nikitchm/naumannlab_2p1/projects/NL_2p1/NL_2p1 overview.html

2

projects

common parts & manuals

coding

Teensy_Arduino

electronics

stepper motor drivers

Sparkfun Easydriver

Sparkfun Easydriver

Uctronics-power-source_mount

v1

laser_module_power_control_mount

STL

laser_module_power_control_mount v2

F3D

laser_module_power_control_mount_eng0.1_inf40_sup_adh_UMS3

GCODE

laser_module_power_control_mount_v1

PNG

UMS3_laser_module_power_control_mount

3MF

v2

laser_module_power_control_mount v6

F3D

laser_module_power_control_mount_v2

STL

laser_module_power_control_mount_v2

PNG

laser_module_power_control_mount_v2_back

JPG

laser_module_power_control_mount_v2_eng0.1_inf40_sup_no-adh_UMS3

GCODE

laser_module_power_control_mount_v2_front

JPG

UMS3_laser_module_power_control_mount_v2

3MF

v2.1

laser_module_power_control_mount v7

F3D

laser_module_power_control_mount_v2

PNG

laser_module_power_control_mount_v2_back

JPG

laser_module_power_control_mount_v2_front

JPG

laser_module_power_control_mount_v2.1

STL

laser_module_power_control_mount_v2.1_eng0.1_inf40_no-sup_no-adh_UMS3

GCODE

laser_module_power_control_mount_v2.1_UMS3

3MF

Uctronics power source with relay mount

USB

FLIR Cameras

files

asset_pdf_25493243

PDF

cmosis_CMV4000-10-2015-773293

PDF

GS3-U3-Technical-Reference

PDF

FLIR Cameras

LED

Thorlabs

M780L3-SpecSheet

PDF

Thorlabs M780L3

manufacturing

3D printing

3D printing

Duke University Co-Lab specific printing

Olympus objective

files

N20X-PFH-Objective

STEP

Olympus XLUMPLFLN20XW

Common parts

NL_2p1

extra modules

behavioral imaging

files

tissue camera past objective simulation

JSON

tissue-camera_ray-optics-simulation_sketch1

PNG

Behavioral imaging

Tissue camera

cooling system

Cooling system

enclosure

Enclosure

LED lighting

software modules

Software modules

stage

files

NL-2p1_z-stage actuator

PNG

Stage

Extra modules

Projector system

Spectra-Physics Insight-X3

Stepper motors

files

2p-scanning

XLSX

3D Model

NL-2p1_3D-model

PNG

NL-2p1_asmbly.xlsx

main scanning path

pre-scanner

pics

NL-2p1_beam-forming module

PNG

NL-2p1_periscope

PNG

NL-2p1_pre-scanner

PNG

Beam forming

construction, alignment

maintenance alignment

Periscope

Pre-scanner

scanner

pics

NL-2p1_parabolic-galvo-scanner

PNG

Parabolic galvo scanner

Scan-Tube lens system

Main scanning path

Objective

Piezo motor

Shutter

parts and purchasing system

Purchasing system

path 2 - Photostimulation module

path 2 - Photostimulation module

Photostim Galvo Scanner

Pre-SLM

Scan-Tube Lens system & Polarization beamsplitter

SLM

SLM-to-galvo

PMT detection system

files

alignment

20210906_195607

JPG

20210906_202945

JPG

20210906_203235

JPG

20210907_190710

JPG

20210907_190715

JPG

20210907_193334

JPG

20210907_193513

JPG

20210907_193956

JPG

20210908_090937

JPG

spectra

FF01-554_23_Spectrum

TXT

FF01-590_36_Spectrum

TXT

NL-2p1_filters-dichroics_spectra

PNG

tmp

red_fluorophores_filters_sources2b

PNG

NL-2p1_green-channel

PNG

NL-2p1_green-channel_optics

PNG

NL-2p1_PMT detection system

PNG

NL-2p1_PMT detection system_hightlighted optics

PNG

NL-2p1_red-channels

PNG

NL-2p1_red-channels_optics

PNG

maintenance alignment

PMT detection system

PMT detection system spectra

Software assemblies and usage

Software assemblies and usage

Design of the modular two-photon microscope with photostimulation implemented in Naumann Lab

NL_2p1 content

NL_2p1 overview

TODO

# NL_2p1 overview

The NL-2p1 is a custom built two-photon laser microscope designed and constructed for the Eva Naumann's lab at Duke University. It features 2 scanning paths (which can be used for imaging and photostimulation) with an SLM in one of the paths, 4 PMT detection channels, behavioral and tissue cameras, 2D stage for positioning the sample under the microscope (for vertical positioning, the detection module is moved), and several experimental setups for zebrafish studies.

The 3D model of the microscope can be viewed and downloaded here. Note that the online version of the model is opened in a browser and doesn't require an access to Fusion 360 software. However, the experience of viewing the model online differs quite significantly from opening the model directly in Fusion 360, and we recommend the latter if possible.

See NL_2p1 content for links to the different parts / modules of the microscope, alignment, software, etc..

Table Of Contents

NL_2p1 overview
