nikitchm/naumannlab_2p1/projects/NL_2p1/files/2p-scanning.xlsx

Sheet: rigs
cat2 | cat1 | cat0 | assembly | subtotal | part name | Qty | Price ea, $ | url | vendor | catalog # | pic | lead time | extra info | Notes
 | General Settings :
 |  | Root pictures' folder : |  |  | File:////C:\Users\nikit\Dropbox_max\rnd\microframe\pics\
 |  | Template for the file hyperlink: |  |  | HYPERLINK(rigs!$E$3&"", "") |  |  |  |  |  |  |  |  | To turn it into a valid hyperlink, fill the space in between the quotation marks and add "=".
 |  | Example of referring to a file: |  |  | N20X-PFH.jpg
 | TODO |  |  |  | ?add a type column (optics, opto-mech, etc)?; ?Cat (Category) / Class / Descriptor? ; "units column"
 |  |  | duke-2p-scanner < |  |  |  | 0.00
 |  |  |  |  | Pre-rig
 |  |  |  |  | Upper kinematic
 |  |  |  |  | Scanner
 |  |  |  |  | Detection
 |  |  |  |  | Stage
 |  |  |  |  | Behavior
 |  |  |  |  | Stimulation
 |  |  | > |  | slm-ChR2 stim
 |  |  | 2p-microscope 1 < |  |  |  | #REF!
 |  | pre-rig |  |  | pre-rig assembly 1 < | 1 | 2008.48
 |  | Vertical Kinematics |  |  | vertical kinematics 1 < | 1 | 1208.30 |  |  |  |  |  |  | todo: ER rodes might be wrong
 |  | Scanner |  |  | scanner 1 < | 1 | 8664.13
 |  | Detection-primary |  |  | 0 | 1 | 0.00 |  |  |  |  |  |  | TODO: optimize lenses, filter and the dichroic
 |  | Detection-secondary |  |  | Single 2ry channel asmbly < | 1 | 5420.22 |  |  |  |  |  |  | TODO: optimize lenses, filter and the dichroic
 |  | Detection-shutter |  |  | objective shutter, Uniblitz VS25-based, v1 < | 1 | 985.00
 |  | Stage |  |  | DIY, acrylic < | 1 | 1552.16 |  |  |  |  |  |  | IR illumination is likely incorrect
 |  | stage-motion |  |  | 3 1-axis DIY, micrometer based stages < | 1 | 2494.54
 |  | Beh im |  |  | Grasshopper3NIR, singlet lens focusing 1 < | 1 | 2091.64 |  |  |  |  |  |  | todo: filtes, IR illumination,
 |  | experiments |  |  |  | 1
 |  | slm-ChR2 stim |  |  |  | 1
 |  | extra stuff, not in design |  |  | Extra stuff < | 1 | 0.00 |  |  |  |  |  |  | the total price will depend on what is decided to include in the order…
 |  |  |  |  | #REF! | 1 | #REF!
 |  |  |  |  | #REF! | 1 | #REF!
 |  |  |  |  | Plössl-type 50mm scan lens < | 1 | 235.52
 |  |  |  |  | 50mm FL, Ø30 Achromat Doublet, w/o XY adjustment < | 1 | 140.15
 |  |  | > |  | AC508-300-B - f=300.0 mm, Ø2" Achromatic Doublet, ARC: 650-1050 nm | 1 | 134.64
 |  |  | consider swapping all the protected silver mirrors with Ultrafast-enhanced silver mirrors: |  |  |  |  |  |  |  |  |  |  | UM10-AG - Ø1" Ultrafast-Enhanced Silver Mirror, 750 - 1000 nm
 |  |  | they offer lower (specified) dispertion and 3% higher reflectance
 |  |  | extra2 <
 |  |  |  |  | extra2 < | 1 | 0
 |  |  | > |  | extra3 < | 1 | 0
 |  |  | extra3 <
 |  |  | > |  | extra4 < | 1 | 0.00
 |  |  | 2p-microscope 2 < | 44784.99
pre-rig < |  |  |  | 4880.49
 |  |  |  |  | laser telescope 2 < | 1 | 530.68 |  |  |  | telescope_asmbly1.png
 |  |  |  |  | precision pinhole < | 1 | 269.32 |  |  |  | mounted_precision-pinhole_50um_xy-mount.png
 |  |  |  |  | power meter with display 1-asmbly for attenuator < | 1 | 1883.47 |  |  |  | power meter-attenuator asmbly.png
 |  |  |  |  | half-waveplate + Glan-polarizer diy 1 < | 1 | 1894.95 |  |  |  | power-controller-4_v4-b.png
> |  |  |  |  | rig shutter, 5W beam block, diy3 < | 1 | 302.07 |  |  |  | 0
Vertical Kinematics < |  |  |  | 949.14
 |  |  |  |  | 12"x18" vertical board < | 1 | 313.46 |  |  |  | 12inx18in vertical board.png
> |  |  |  |  | periscope 2 arms -1 < | 1 | 635.68 |  |  |  | periscope_2arms-1_v5.png
Scanner, x-y-z <
 |  | parabolic-mirror galvo conjugation asmbly < |  | 6238.13
 |  |  |  |  | galvo-parbolic-conjugate-system, unmounted < | 1 | 5922.27
 |  | > |  |  | galvo-parbolic-conjugate-system mount < | 1 | 315.86
 |  | ETL z-scanner <> |  |  | ETL mounted z-scanner 1 < | 1 | 2236.49
 |  | scan-tube lens assembly < |  | 1322.62
 |  |  |  |  | Plössl-type 40mm scan lens < | 1 | 283.30
 |  |  |  |  | Mounted 250mm tube lens, AC508-250-B + CXY2 < | 1 | 333.09
> |  | > |  |  | Scanner telescope 2" 180degree steering and suport -2 | 1 | 706.23
Detection < |  |  |  | 20639.78
 |  | Tissue Camera <> |  |  | Grasshopper3NIR (1" sensor) assembly < | 1 | 1344.24
 |  | primary detection arm < |  |  | main channel, Hamamatsu-R3896_side-on-PMT, v1 < | 1 | 5017.24
 |  | secondary detection arm < |  |  | Single 2ry channel asmbly < | 1 | 5420.22
 |  | objective asmbly <> |  |  | Olympus XLUMPLFLN20XW objective, SM1 interface < | 1 | 6916.86
 |  | z-stage mounts <> |  |  | vertical stage servo and mounts, v1 < | 1 | 1021.22
 |  | detection channels filters and dichroics < |  |  | mCherry dichroic/filter set, v1< | 1 | 920.00
> |  | > |  |  | reminder: choose dichroic/filter set for the 1st 2ry channel | -1
DAQ card for the imaging part of the microscope < |  |  |  |  | NI PCIe-6374, 4 AI (16-Bit, 3.5 MS/s/ch), 2 AO (16 bit, 3.3 MS/s), 24 DIO | 1 | 2380 | https://www.ni.com/en-us/support/model.pcie-6374.html | National Instruments | PCIe-6374
> |  |  | > |  | reminder: DAQ card: 1 input channel | -3
Stage <> |  |  |  |  | DIY, acrylic < | 1 | 1552.16
stage-motion <> |  |  |  |  | 3 1-axis DIY, micrometer based stages < | 1 | 2494.54
Beh im <> |  |  |  |  | Grasshopper3NIR, singlet lens focusing 1 < | 1 | 2091.64

Sheet: parts-vendors
Vendors | cat1 | cat0 | assembly | Part name | Qty | Price ea, $ | url | vendor | catalog # | pic | lead time, weeks | extra info | manufacturer | Notes
Thorlabs <
 | Mechanical <
 |  | Construction rail system <
 |  |  |  | XT95-1500 - 95 mm Construction Rail, Clear Anodized, L = 1500 mm | 1 | 306.00 | https://www.thorlabs.com/thorproduct.cfm?partnumber=XT95-1500 | thorlabs | XT95-1500 | XT95-1500.jpg |  |  |  | Main vertical column. ?Cut down to 4'?
 |  |  |  | XT95P3 - Base Plate for 95 mm Rails | 1 | 51.51 | https://www.thorlabs.com/thorproduct.cfm?partnumber=XT95P3 | thorlabs | XT95P3 | XT95P3.jpg |  |  |  | For vertical mounting of 95 mm Rails
 |  |  |  | XT95P11 - Drop-On Rail Carriage for 95 mm Rails, 1/4"-20 Tapped Holes | 1 | 83.39 | https://www.thorlabs.com/thorproduct.cfm?partnumber=XT95P11 | thorlabs | XT95P11
 |  |  |  | XT95P12 - Rail Plate for 95 mm Rails, 1/4"-20 Tapped Holes | 1 | 46.16 | https://www.thorlabs.com/thorproduct.cfm?partnumber=XT95P12 | thorlabs | XT95P12 | XT95P12.jpg
 |  |  |  | XT66-500 - 66 mm Construction Rail, L = 500 mm | 1 | 85.43 | https://www.thorlabs.com/thorproduct.cfm?partnumber=XT66-500 | thorlabs | XT66-500 | XT66-500.jpg |  |  |  | Upper side-arm holding two translation mirrors
 |  | > |  | XT66C4 - Clamping Platform for 66 mm Rails, 1/4" Counterbored Slot, 40 mm Long | 2 | 28.56 | https://www.thorlabs.com/thorproduct.cfm?partnumber=XT66C4 | thorlabs | XT66C4 | XT66C4.jpg
 |  | Ø1/2" Post mounting bases <
 |  |  |  | BA1 - Mounting Base, 1" x 3" x 3/8" | 1 | 5.60 | https://www.thorlabs.com/thorproduct.cfm?partnumber=BA1 | thorlabs | BA1 | BA1.jpg
 |  |  |  | BA2 - Mounting Base, 2" x 3" x 3/8" | 1 | 7.30 | https://www.thorlabs.com/thorproduct.cfm?partnumber=BA2 | thorlabs | BA2 | BA2.jpg
 |  |  |  | BA1S - Mounting Base, 1" x 2.3" x 3/8" | 1 | 5.20 | https://www.thorlabs.com/thorproduct.cfm?partnumber=BA1S | thorlabs | BA1S | BA1S.jpg
 |  |  |  | BE1 - Ø1.25" Studded Pedestal Base Adapter, 1/4"-20 Thread | 1 | 9.49 | https://www.thorlabs.com/thorproduct.cfm?partnumber#BE1-P5 | thorlabs | BE1
 |  |  |  | BE1R - Ø1.25" Magnetic Studded Pedestal Base Adapter, 1/4"-20 Thread | 1 | 16.73 | https://www.thorlabs.com/thorproduct.cfm?partnumber#BE1R#ad-image-0 | thorlabs | BE1R
 |  |  |  | BE1T - Tapped Mechanical Component Base, 1/4"-20 Thread | 1 | 10.06 | https://www.thorlabs.com/thorproduct.cfm?partnumber=BE1T | thorlabs | BE1T
 |  |  |  | BE2T - Tapped Mechanical Component Base, 8-32 Thread | 1 | 10.06 | https://www.thorlabs.com/thorproduct.cfm?partnumber=BE2T | thorlabs | BE2T
 |  |  |  | RS8M - Ø25 mm Post Spacer, Thickness = 8 mm | 1 | 8.77 | https://www.thorlabs.com/thorproduct.cfm?partnumber=RS8M | thorlabs | RS8M
 |  |  |  | CF038-P5 - Clamping Fork, 0.38" Counterbored Slot, Universal, 5 Pack | 5 | 41.40 | https://www.thorlabs.com/thorproduct.cfm?partnumber=CF038-P5 | thorlabs | CF038-P5
 |  |  |  | CF125 - Clamping Fork, 1.24" Counterbored Slot, Universal | 1 | 8.95 | https://www.thorlabs.com/thorproduct.cfm?partnumber#CF125#ad-image-0 | thorlabs | CF125
 |  |  |  | CF125C - Clamping Fork, 1.24" Counterbored Slot, 1/4"-20 Captive Screw | 1 | 11.69 | https://www.thorlabs.com/thorproduct.cfm?partnumber=CF125C#ad-image-0 | thorlabs | CF125C
 |  | > |  | CF175 - Clamping Fork, 1.76" Counterbored Slot, Universal | 1 | 10.30 | https://www.thorlabs.com/thorproduct.cfm?partnumber#CF175-P5 | thorlabs | CF175
 |  | stages <
 |  |  |  | DT12 - 1/2" Dovetail Translation Stage, 8-32 Taps | 1 | 84.14 | https://www.thorlabs.com/thorproduct.cfm?partnumber=DT12 | thorlabs | DT12
 |  | >
 |  | Ø1/2" Post holders < |  |  |  |  | https://www.thorlabs.com/newgrouppage9.cfm?objectgroup_id=1268 | thorlabs
 |  |  |  | PH1 - Ø1/2" Post Holder, Spring-Loaded Hex-Locking Thumbscrew, L = 1" | 1 | 7.03 | https://www.thorlabs.com/thorproduct.cfm?partnumber=PH1 | thorlabs | PH1 | PH1.jpg
 |  |  |  | PH1.5 - Ø1/2" Post Holder, Spring-Loaded Hex-Locking Thumbscrew, L = 1.5" | 1 | 7.22 | https://www.thorlabs.com/thorproduct.cfm?partnumber=PH1.5 | thorlabs | PH1.5 | PH1.5.jpg
 |  |  |  | PH2 - Ø1/2" Post Holder, Spring-Loaded Hex-Locking Thumbscrew, L = 2" | 1 | 7.70 | https://www.thorlabs.com/thorproduct.cfm?partnumber=PH2 | thorlabs | PH2 | PH2.jpg
 |  |  |  | PH3 - Ø1/2" Post Holder, Spring-Loaded Hex-Locking Thumbscrew, L = 3" | 1 | 8.27 | https://www.thorlabs.com/thorproduct.cfm?partnumber=PH3=ad-image-0 | thorlabs | PH3 | PH3.jpg
 |  | > |  | PH4 - Ø1/2" Post Holder, Spring-Loaded Hex-Locking Thumbscrew, L = 4" | 1 | 9.45 | https://www.thorlabs.com/thorproduct.cfm?partnumber=PH4#ad-image-0 | thorlabs | PH4
 |  | Ø1/2" Posts < |  |  |  |  | https://www.thorlabs.com/newgrouppage9.cfm?objectgroup_id=1266 | thorlabs
 |  |  |  | TR075 - Ø1/2" Optical Post, SS, 8-32 Setscrew, 1/4"-20 Tap, L = 0.75" | 1 | 4.74 | https://www.thorlabs.com/thorproduct.cfm?partnumber=TR075 | thorlabs | TR075 | TR075.jpg |  |  |  | SS-stainless steel
 |  |  |  | TR1 - Ø1/2" Optical Post, SS, 8-32 Setscrew, 1/4"-20 Tap, L = 1" | 1 | 4.74 | https://www.thorlabs.com/thorproduct.cfm?partnumber=TR1 | thorlabs | TR1 | TR1.jpg
 |  |  |  | TR1.5 - Ø1/2" Optical Post, SS, 8-32 Setscrew, 1/4"-20 Tap, L = 1.5" | 1 | 4.97 | https://www.thorlabs.com/thorproduct.cfm?partnumber=TR1.5 | thorlabs | TR1.5 | TR1.5.jpg
 |  |  |  | TR2 - Ø1/2" Optical Post, SS, 8-32 Setscrew, 1/4"-20 Tap, L = 2" | 1 | 5.19 | https://www.thorlabs.com/thorproduct.cfm?partnumber=TR2 | thorlabs | TR2 | TR2.jpg
 |  |  |  | TR3 - Ø1/2" Optical Post, SS, 8-32 Setscrew, 1/4"-20 Tap, L = 3" | 1 | 5.42 | https://www.thorlabs.com/thorproduct.cfm?partnumber=TR3 | thorlabs | TR3 | TR3.jpg
 |  |  |  | TR4 - Ø1/2" Optical Post, SS, 8-32 Setscrew, 1/4"-20 Tap, L = 4" | 1 | 5.87 | https://www.thorlabs.com/thorproduct.cfm?partnumber=TR4 | thorlabs | TR4 | TR4.jpg
 |  |  |  | TR6 - Ø1/2" Optical Post, SS, 8-32 Setscrew, 1/4"-20 Tap, L = 6" | 1 | 6.91 | https://www.thorlabs.com/thorproduct.cfm?partnumber=TR6 | thorlabs | TR6 | TR6.jpg
 |  | > |  | TR8 - Ø1/2" Optical Post, SS, 8-32 Setscrew, 1/4"-20 Tap, L = 8" | 1 | 8.28 | https://www.thorlabs.com/thorproduct.cfm?partnumber=TR8 | thorlabs | TR8 | TR8.jpg
 |  | Ø1/2" Post clamps <
 |  |  |  | RA180 - Right-Angle End Clamp for Ø1/2" Posts, 1/4"-20 Stud and 3/16" Hex | 1 | 10.81 | https://www.thorlabs.com/thorproduct.cfm?partnumber=RA180 | thorlabs | RA180 | RA180.jpg
 |  |  |  | RA90 - Right-Angle Clamp for Ø1/2" Posts, 3/16" Hex | 1 | 9.76 | https://www.thorlabs.com/thorproduct.cfm?partnumber=RA90 | thorlabs | RA90 | RA90.jpg
 |  | > |  | SWC - Rotating Clamp for Ø1/2" Posts, 360° Continuously Adjustable, 3/16" Hex | 1 | 23.56 | https://www.thorlabs.com/thorproduct.cfm?partnumber=SWC | thorlabs | SWC | SWC.jpg
 |  | Ø1.5" <
 |  |  |  | C1515 - Ø1.5" Mounting Post Bracket, 1/4"-20 Taps | 4 | 100.98 | https://www.thorlabs.com/thorproduct.cfm?partnumber=C1515 | thorlabs | C1515 | C1515.jpg |  |  |  | ours didn’t have a clamp…
 |  | > |  | P8 - Ø1.5" Mounting Post, 1/4"-20 Taps, L = 8" | 4 | 56.36 | https://www.thorlabs.com/thorproduct.cfm?partnumber=P8 | thorlabs | P8 | P8.jpg
 |  | Arm clamps <
 |  |  |  | VC1 - Small V-Clamp with PM3 Clamping Arm, 0.75" Long | 1 | 40.55 | https://www.thorlabs.com/thorproduct.cfm?partnumber=VC1 | thorlabs | VC1 | VC1.jpg |  |  |  | Comes with PM4 arm, which isn't large enough for the liquid lens and has to be replaced with the PM4 arm
 |  |  |  | PM4 - Large Adjustable Clamping Arm, 6-32 Threaded Post | 1 | 22.95 | https://www.thorlabs.com/thorproduct.cfm?partnumber=PM4 | thorlabs | PM4 | PM4.jpg
 |  | > |  | PM3 - Small Adjustable Clamping Arm, 6-32 Threaded Post | 1 | 18.77 | https://www.thorlabs.com/thorproduct.cfm?partnumber=PM3 | thorlabs | PM3 | PM3.jpg |  |  |  | In the rig -- discontinued PM2
 |  | 30mm cage system <
 |  |  |  | C6W - 30 mm Cage Cube, Ø6 mm Through Holes | 1 | 63.75 | https://www.thorlabs.com/thorproduct.cfm?partnumber=C6W | thorlabs | C6W | C6W.jpg
 |  |  |  | C4W - 30 mm Cage Cube | 1 | 60.44 | https://www.thorlabs.com/thorproduct.cfm?partnumber=C4W | thorlabs | C4W | C4W.jpg
 |  |  |  | C4W-CC - 30 mm Cage Cube Connector for C4W and C6W Series Cubes | 1 | 54.65 | https://www.thorlabs.com/thorproduct.cfm?partnumber#C4W-CC | thorlabs | C4W-CC
 |  |  |  | B4C - Kinematic Cage Cube Platform for C4W/C6W | 1 | 98.43 | https://www.thorlabs.com/thorproduct.cfm?partnumber=B4C | thorlabs | B4C | B4C.jpg
 |  |  |  | FFM1 - 30-mm-Cage-Compatible Rectangular Filter Mount | 1 | 58.40 | https://www.thorlabs.com/thorproduct.cfm?partnumber=FFM1 | thorlabs | FFM1 | FFM1.jpg
 |  |  |  | SM1CP2 - Externally SM1-Threaded End Cap | 1 | 17.75 | https://www.thorlabs.com/thorproduct.cfm?partnumber=SM1CP2 | thorlabs | SM1CP2 | SM1CP2.jpg
 |  |  |  | B1C - Blank Cover Plate | 1 | 18.77 | https://www.thorlabs.com/thorproduct.cfm?partnumber=B1C | thorlabs | B1C | B1C.jpg
 |  |  |  | ER6 - Cage Assembly Rod, 6" Long, Ø6 mm | 1 | 8.65 | https://www.thorlabs.com/thorproduct.cfm?partnumber=ER6 | thorlabs | ER6 | ER6.jpg
 |  |  |  | ER8 - Cage Assembly Rod, 8" Long, Ø6 mm | 1 | 11.70 | https://www.thorlabs.com/thorproduct.cfm?partnumber=ER8 | thorlabs | ER8 | ER8.jpg
 |  |  |  | CP02B - 30 mm Cage Mounting Bracket | 1 | 14.08 | https://www.thorlabs.com/thorproduct.cfm?partnumber=CP02B | thorlabs | CP02B | CP02B.jpg
 |  |  |  | SM1T2 - SM1 (1.035"-40) Coupler, External Threads, 0.5" Long | 1 | 20.30 | https://www.thorlabs.com/thorproduct.cfm?partnumber=SM1T2 | thorlabs | SM1T2 | SM1T2.jpg
 |  |  |  | SM1L03 - SM1 Lens Tube, 0.30" Thread Depth, One Retaining Ring Included | 1 | 12.16 | https://www.thorlabs.com/thorproduct.cfm?partnumber=SM1L03 | thorlabs | SM1L03 | SM1L03.jpg
 |  |  |  | SM1L05 - SM1 Lens Tube, 0.50" Thread Depth, One Retaining Ring Included | 1 | 12.59 | https://www.thorlabs.com/thorproduct.cfm?partnumber=SM1L05 | thorlabs | SM1L05 | SM1L05.jpg
 |  |  |  | SM1L10 - SM1 Lens Tube, 1.00" Thread Depth, One Retaining Ring Included | 1 | 14.25 | https://www.thorlabs.com/thorproduct.cfm?partnumber=SM1L10 | thorlabs | SM1L10 | SM1L10.jpg
 |  |  |  | SM30L05 - SM30 Lens Tube, 1/2" Thread Depth, One Retaining Ring Included | 1 | 28.05 | https://www.thorlabs.com/thorproduct.cfm?partnumber#SM30L05 | thorlabs | SM30L05
 |  |  |  | SM30L10 - SM30 Lens Tube, 1" Thread Depth, One Retaining Ring Included | 1 | 30.09 | https://www.thorlabs.com/thorproduct.cfm?partnumber=SM30L10 | thorlabs | SM30L10
 |  |  |  | SM1RR - SM1 Retaining Ring for Ø1" Lens Tubes and Mounts | 1 | 4.50 | https://www.thorlabs.com/thorproduct.cfm?partnumber=SM1RR | thorlabs | SM1RR | SM1RR.jpg
 |  |  |  | SM1A9 - Adapter with External C-Mount Threads and Internal SM1 Threads | 1 | 18.82 | https://www.thorlabs.com/thorproduct.cfm?partnumber=SM1A9 | thorlabs | SM1A9 | SM1A9.jpg
 |  |  |  | CP35 - 30 mm Cage Plate with Ø1" Double Bore, 8-32 Tap | 1 | 18.68 | https://www.thorlabs.com/thorproduct.cfm?partnumber=CP35 | thorlabs | CP35 | CP35.jpg |  |  |  | The replacement for the now obsolete CP06
 |  |  |  | CP20S - 30 mm Cage System Iris, Ø20.0 mm Maximum Aperture | 1 | 88.00 | https://www.thorlabs.com/thorproduct.cfm?partnumber=CP20S | thorlabs | CP20S | CP20S.jpg
 |  |  |  | LCP02 - 30 mm to 60 mm Cage Plate Adapter, 8-32 Tap | 1 | 39.78 | https://www.thorlabs.com/thorproduct.cfm?partnumber=LCP02 | thorlabs | LCP02 | LCP02.jpg
 |  |  |  | SPT1 - Coarse ±1 mm XY Slip Plate Positioner, 30 mm Cage Compatible | 1 | 66.55 | https://www.thorlabs.com/thorproduct.cfm?partnumber=SPT1 | thorlabs | SPT1 | SPT1.jpg
 |  |  |  | CXY1 - 30 mm Cage System, XY Translating Lens Mount for Ø1" Optics | 1 | 187.20 | https://www.thorlabs.com/thorproduct.cfm?partnumber=CXY1=ad-image-0 | thorlabs | CXY1 | CXY1.jpg
 |  |  |  | CP360R - Pivoting, Quick-Release, Ø1" Optic Mount for 30 mm Cage System | 1 | 95.63 | https://www.thorlabs.com/thorproduct.cfm?partnumber=CP360R | thorlabs | CP360R | CP360R.jpg
 |  |  |  | CRM1 - Cage Rotation Mount for Ø1" Optics, SM1 Threaded, 8-32 Tap | 1 | 87.39 | https://www.thorlabs.com/thorproduct.cfm?partnumber=CRM1 | thorlabs | CRM1 | CRM1.jpg
 |  |  |  | CP30 - 30 mm to 30 mm Cage System Right-Angle Adapter | 1 | 51.50 | https://www.thorlabs.com/thorproduct.cfm?partnumber=CP30 | thorlabs | CP30 | CP30.jpg
 |  |  |  | CP08 - SM1-Threaded 30 mm Cage Plate with Flexure Clamping, 1 Retaining Ring, 8-32 Tap | 1 | 19.79 | https://www.thorlabs.com/thorproduct.cfm?partnumber=CP08 | thorlabs | CP08 | CP08.jpg
 |  |  |  | CP03 - Ø35 mm Aperture, 30 mm Cage Plate, 0.35" Thick, 8-32 Tap | 1 | 18.77 | https://www.thorlabs.com/thorproduct.cfm?partnumber#CP03 | thorlabs | CP03
 |  | 60mm cage system <
 |  |  |  | LCP01 - 60 mm Cage Plate, SM2 Threads, 0.5" Thick, 8-32 Tap (Two SM2RR Retaining Rings Included) | 1 | 38.76 | https://www.thorlabs.com/thorproduct.cfm?partnumber=LCP01 | thorlabs | LCP01
 |  |  |  | LCP02 - 30 mm to 60 mm Cage Plate Adapter, 8-32 Tap | 1 | 39.78 | https://www.thorlabs.com/thorproduct.cfm?partnumber=LCP02 | thorlabs | LCP02
 |  |  |  | LCP01B - 60 mm Cage Mounting Bracket | 1 | 30.35 | https://www.thorlabs.com/thorproduct.cfm?partnumber#LCP01B | thorlabs | LCP01B
 |  |  |  | LCP08 - 60 mm Cage Plate, SM2 Threads, Enhanced Clamping, 0.5" Thick, 8-32 Tap (One SM2RR Retaining Ring Included) | 1 | 49.98 | https://www.thorlabs.com/thorproduct.cfm?partnumber#LCP08 | thorlabs | LCP08
 |  |  |  | LCP09 - 60 mm Cage Plate with Ø2.2" (Ø56.0 mm) Double Bore for SM2 Lens Tube Mounting | 1 | 45.72 | https://www.thorlabs.com/thorproduct.cfm?partnumber=LCP09 | thorlabs | LCP09
 |  |  |  | CXY2 - 60 mm Cage System Translating Lens Mount for Ø2" Optics | 1 | 198.45 | https://www.thorlabs.com/thorproduct.cfm?partnumber=CXY2 | thorlabs | CXY2
 |  | adapters <
 |  |  |  | SM1A16 - Adapter with External SM1 Threads and Internal SM30 Threads | 1 | 21.93 | https://www.thorlabs.com/thorproduct.cfm?partnumber#SM1A16 | thorlabs | SM1A16
 |  |  |  | SM1A39 - Adapter with External C-Mount Threads and External SM1 Threads | 1 | 19.99 | https://www.thorlabs.com/thorproduct.cfm?partnumber=SM1A39 | thorlabs | SM1A39
 |  |  |  | SM2A27 - Adapter with External SM2 Threads and Internal M49 x 0.75 Threads | 1 | 31.12 | https://www.thorlabs.com/thorproduct.cfm?partnumber#SM2A27 | thorlabs | SM2A27
 |  |  |  | SM2A30 - Adapter with External SM2 Threads and Internal M43 x 0.5 Threads | 1 | 16.56 | https://www.thorlabs.com/thorproduct.cfm?partnumber#SM2A30 | thorlabs | SM2A30
 |  |  |  | SM1A16 - Adapter with External SM1 Threads and Internal SM30 Threads | 1 | 21.93 | https://www.thorlabs.com/thorproduct.cfm?partnumber#SM1A16 | thorlabs | SM1A16
 |  |  |  | SM1A9 - Adapter with External C-Mount Threads and Internal SM1 Threads | 1 | 18.82 | https://www.thorlabs.com/thorproduct.cfm?partnumber#SM1A9 | thorlabs | SM1A9
 |  |  |  | SM1A12 - Adapter with External SM1 Threads and Internal M25 x 0.75 Threads | 1 | 21.86 | https://www.thorlabs.com/thorproduct.cfm?partnumber=SM1A12 | thorlabs | SM1A12
 |  | >
 |  | ER rods <
 |  |  |  | ER025 - Cage Assembly Rod, 1/4" Long, Ø6 mm | 1 | 5.05 | https://www.thorlabs.com/thorproduct.cfm?partnumber=er025 | thorlabs | ER025 | er025.jpg
 |  |  |  | ER05 - Cage Assembly Rod, 1/2" Long, Ø6 mm | 1 | 5.05 | https://www.thorlabs.com/thorproduct.cfm?partnumber=ER05 | thorlabs | ER05 | ER05.jpg
 |  |  |  | ER05-P4 - Cage Assembly Rod, 1/2" Long, Ø6 mm, 4 Pack | 1 | 19.19 | https://www.thorlabs.com/thorproduct.cfm?partnumber=ER05-P4 | thorlabs | ER05-P4 | ER05-P4.jpg
 |  |  |  | ER1 - Cage Assembly Rod, 1" Long, Ø6 mm | 1 | 5.05 | https://www.thorlabs.com/thorproduct.cfm?partnumber=ER1 | thorlabs | ER1 | ER1.jpg
 |  |  |  | ER1-P4 - Cage Assembly Rod, 1" Long, Ø6 mm, 4 Pack | 1 | 19.19 | https://www.thorlabs.com/thorproduct.cfm?partnumber=ER1-P4 | thorlabs | ER1-P4 | ER1-P4.jpg
 |  |  |  | ER1.5 - Cage Assembly Rod, 1.5" Long, Ø6 mm | 1 | 5.85 | https://www.thorlabs.com/thorproduct.cfm?partnumber=ER1.5 | thorlabs | ER1.5 | ER1.5.jpg
 |  |  |  | ER1.5-P4 - Cage Assembly Rod, 1.5" Long, Ø6 mm, 4 Pack | 1 | 22.22 | https://www.thorlabs.com/thorproduct.cfm?partnumber=ER1.5-P4 | thorlabs | ER1.5-P4 | ER1.5-P4.jpg
 |  |  |  | ER2 - Cage Assembly Rod, 2" Long, Ø6 mm | 1 | 6.10 | https://www.thorlabs.com/thorproduct.cfm?partnumber=ER2 | thorlabs | ER2 | ER2.jpg
 |  |  |  | ER2-P4 - Cage Assembly Rod, 2" Long, Ø6 mm, 4 Pack | 1 | 23.18 | https://www.thorlabs.com/thorproduct.cfm?partnumber=ER2-P4 | thorlabs | ER2-P4 | ER2-P4.jpg
 |  |  |  | ER3 - Cage Assembly Rod, 3" Long, Ø6 mm | 1 | 6.60 | https://www.thorlabs.com/thorproduct.cfm?partnumber=ER3 | thorlabs | ER3 | ER3.jpg
 |  |  |  | ER3-P4 - Cage Assembly Rod, 3" Long, Ø6 mm, 4 Pack | 1 | 25.08 | https://www.thorlabs.com/thorproduct.cfm?partnumber=ER3-P4 | thorlabs | ER3-P4 | ER3-P4.jpg
 |  |  |  | ER4 - Cage Assembly Rod, 4" Long, Ø6 mm | 1 | 7.10 | https://www.thorlabs.com/thorproduct.cfm?partnumber=ER4 | thorlabs | ER4 | ER4.jpg
 |  |  |  | ER4-P4 - Cage Assembly Rod, 4" Long, Ø6 mm, 4 Pack | 1 | 26.98 | https://www.thorlabs.com/thorproduct.cfm?partnumber=ER4-P4 | thorlabs | ER4-P4 | ER4-P4.jpg
 |  |  |  | ER6 - Cage Assembly Rod, 6" Long, Ø6 mm | 1 | 8.65 | https://www.thorlabs.com/thorproduct.cfm?partnumber=ER6 | thorlabs | ER6 | ER6.jpg
 |  |  |  | ER6-P4 - Cage Assembly Rod, 6" Long, Ø6 mm, 4 Pack | 1 | 32.87 | https://www.thorlabs.com/thorproduct.cfm?partnumber=ER6-P4 | thorlabs | ER6-P4 | ER6-P4.jpg
 |  |  |  | ER8 - Cage Assembly Rod, 8" Long, Ø6 mm | 1 | 12.05 | https://www.thorlabs.com/thorproduct.cfm?partnumber=ER8 | thorlabs | ER8 | ER8.jpg
 |  |  |  | ER8-P4 - Cage Assembly Rod, 8" Long, Ø6 mm, 4 Pack | 1 | 44.46 | https://www.thorlabs.com/thorproduct.cfm?partnumber=ER8-P4 | thorlabs | ER8-P4 | ER8-P4.jpg
 |  |  |  | ER10 - Cage Assembly Rod, 10" Long, Ø6 mm | 1 | 12.70 | https://www.thorlabs.com/thorproduct.cfm?partnumber=ER10 | thorlabs | ER10 | ER10.jpg
 |  |  |  | ER12 - Cage Assembly Rod, 12" Long, Ø6 mm | 1 | 16.80 | https://www.thorlabs.com/thorproduct.cfm?partnumber=ER12 | thorlabs | ER12 | ER12.jpg
 |  | > |  | ER18 - Cage Assembly Rod, 18" Long, Ø6 mm | 1 | 25.50 | https://www.thorlabs.com/thorproduct.cfm?partnumber=ER18 | thorlabs | ER18 | ER18.jpg
 |  |  |  | Optic mounts: |  |  | https://www.thorlabs.com/newgrouppage9.cfm?objectgroup_id=903 | thorlabs
 |  |  |  | KM100 - Kinematic Mirror Mount for Ø1" Optics | 1 | 38.70 | https://www.thorlabs.com/thorproduct.cfm?partnumber=KM100=ad-image-0 | thorlabs | KM100 | KM100.jpg
 |  |  |  | KMSS - Compact Kinematic Mirror Mount, Hex Adjuster, 8-32 Taps for Post Mounting | 1 | 37.87 | https://www.thorlabs.com/thorproduct.cfm?partnumber=KMSS | thorlabs | KMSS
 |  |  |  | KMS - Compact Kinematic Mirror Mount, 8-32 Taps for Post Mounting | 1 | 40.04 | https://www.thorlabs.com/thorproduct.cfm?partnumber=KMS | thorlabs | KMS
 |  |  |  | H45 - 45° Mirror Mount for Ø1" Optics | 1 | 33.75 | https://www.thorlabs.com/thorproduct.cfm?partnumber=H45 | thorlabs | H45 | H45.jpg
 |  |  |  | MA45-2 - 45° Mounting Adapter, Compatible with KM100 and KM200, 8-32 and 1/4"-20 Taps | 1 | 21.52 | https://www.thorlabs.com/thorproduct.cfm?partnumber=MA45-2 | thorlabs | MA45-2 | MA45-2.jpg
 |  |  |  | LM2XY - Translating Lens Mount for Ø2" Optics, 1 Retaining Ring Included | 1 | 154.02 | https://www.thorlabs.com/thorproduct.cfm?partnumber=LM2XY | thorlabs | LM2XY | LM2XY.jpg
 |  |  |  | SM2AD30 - SM2-Threaded Mounting Adapter for Ø30 mm Optics | 1 | 29.61 | https://www.thorlabs.com/thorproduct.cfm?partnumber=SM2AD30 | thorlabs | SM2AD30 | SM2AD30.jpg |  |  |  | adapter to insert AC300-050-B into LM2XY
 |  |  |  | KM100PM - Kinematic Prism Mount, 1.00" Deep, 6-32 Taps | 1 | 75.48 | https://www.thorlabs.com/thorproduct.cfm?partnumber=KM100PM | thorlabs | KM100PM | KM100PM.jpg |  |  |  | most likely this model..
 |  |  |  | SM1PM10 - SM1 Lens Tube Mount for 8 mm and 10 mm Mounted Polarizing Prisms | 1 | 53.00 | https://www.thorlabs.com/thorproduct.cfm?partnumber=SM1PM10 | thorlabs | SM1PM10 | SM1PM10.jpg
 |  |  |  | SMR1 - Ø1" Lens Mount with SM1 Internal Threads and No Retaining Lip, 8-32 Tap | 1 | 19.00 | https://www.thorlabs.com/thorproduct.cfm?partnumber=SMR1 | thorlabs | SMR1 | SMR1.jpg
 |  |  |  | LMR1S - Ø1" Lens Mount with Internal and External SM1 Threads, 8-32 Tap | 1 | 27.54 | https://www.thorlabs.com/thorproduct.cfm?partnumber=LMR1S | thorlabs | LMR1S | LMR1S.jpg |  |  |  | ? Check if it reaches M780L3's internal SM1 thread
 |  |  |  | KCB1 - Right-Angle Kinematic Mirror Mount with Tapped Cage Rod Holes, 30 mm Cage System and SM1 Compatible, 8-32 and 1/4"-20 Mounting Holes | 1 | 143.00 | https://www.thorlabs.com/thorproduct.cfm?partnumber=KCB1 | thorlabs | KCB1 | KCB1.jpg
 |  |  |  | KCB1C - Right-Angle Kinematic Mirror Mount with Smooth Cage Rod Bores, 30 mm Cage System and SM1 Compatible, 8-32 and 1/4"-20 Mounting Holes | 1 | 147.29 | https://www.thorlabs.com/thorproduct.cfm?partnumber=KCB1C#ad-image-0 | thorlabs | KCB1C | KCB1C.jpg
 |  |  |  | Misc:
 |  |  |  | MB1218 - Aluminum Breadboard 12" x 18" x 1/2", 1/4"-20 Taps | 1 | 188.00 | https://www.thorlabs.com/thorproduct.cfm?partnumber=MB1218 | thorlabs | MB1218 | MB1218.jpg |  |  |  | With a manual cut out holes. Rig2: 10 x 8 1/2"
 |  |  |  | MB4 - Aluminum Breadboard 4" x 6" x 1/2", 1/4"-20 Taps | 1 | 44.13 | https://www.thorlabs.com/thorproduct.cfm?partnumber=MB4 | thorlabs | MB4
 |  |  |  | MB4U - Unanodized Aluminum Breadboard, 4" x 4" x 1/2", 1/4"-20 Taps | 1 | 41.00 | https://www.thorlabs.com/thorproduct.cfm?partnumber=MB4U | thorlabs | MB4U | MB4U.jpg |  |  |  | larger than needed. It's better to cut a larger alluminum board to size.
 |  |  |  | MB8 - Aluminum Breadboard 8" x 8" x 1/2", 1/4"-20 Taps | 1 | 77.22 | https://www.thorlabs.com/thorproduct.cfm?partnumber#MB8 | thorlabs | MB8
 |  |  |  | UBP2 - Universal Base Plate, 2.5" x 2.5" x 3/8" | 1 | 36.47 | https://www.thorlabs.com/thorproduct.cfm?partnumber=UBP2 | thorlabs | UBP2 | UBP2.jpg |  |  |  | A different, similar in size, plate was used for galvo mounting
 |  |  |  | PXT1 - PMT Housing, Side-On, 30 mm Cage and SM1 Compatible | 1 | 112.20 | https://www.thorlabs.com/thorproduct.cfm?partnumber=PXT1 | thorlabs | PXT1 | PXT1.jpg
 |  |  |  | VB01B - 18" Vertical Bracket for Breadboards, 1/4"-20 Holes, 1 Piece | 1 | 125.46 | https://www.thorlabs.com/thorproduct.cfm?partnumber=VB01B | thorlabs | VB01B | VB01B.jpg
 | > |  |  | PXT1 - PMT Housing, Side-On, 30 mm Cage and SM1 Compatible | 1 | 112.20 | https://www.thorlabs.com/thorproduct.cfm?partnumber=PXT1 | thorlabs | PXT1
 | Optics <
 |  | Mirrors <
 |  |  |  | PF10-03-P01 - Ø1" Protected Silver Mirror | 1 | 52.02 | https://www.thorlabs.com/thorproduct.cfm?partnumber=PF10-03-P01 | thorlabs | PF10-03-P01 | PF10-03-P01.jpg |  |  |  | reflectance: >97.5% for 450 nm - 2 µm, >96% for 2 - 20 µm (-P01)
 |  |  |  | UM10-AG - Ø1" Ultrafast-Enhanced Silver Mirror, 750 - 1000 nm | 1 | 104.97 | https://www.thorlabs.com/thorproduct.cfm?partnumber=UM10-AG | thorlabs | UM10-AG | UM10-AG.jpg
 |  |  |  | BB1-E02 - Ø1" Broadband Dielectric Mirror, 400-750 nm | 1 | 75.10 | https://www.thorlabs.com/thorproduct.cfm?partnumber=BB1-E02 | thorlabs | BB1-E02 | BB1-E02.jpg
 |  |  |  | BB1-E03 - Ø1" Broadband Dielectric Mirror, 750 - 1100 nm | 1 | 75.10 | https://www.thorlabs.com/thorproduct.cfm?partnumber=BB1-E03 | thorlabs | BB1-E03 | BB1-E03.jpg |  |  |  | reflectance >99.5% for 700-1300nm
 |  | > |  | MPD229-M01 - Ø2" 90° Off-Axis Parabolic Mirror, Prot. Gold, RFL = 2" | 1 | 333.54 | https://www.thorlabs.com/thorproduct.cfm?partnumber=MPD229-M01 | thorlabs | MPD229-M01
 |  | Lens <
 |  |  |  | AC508-300-B: f=300.0 mm, Ø2" Achromatic Doublet, ARC: 650-1050 nm | 1 | 134.64 | https://www.thorlabs.com/thorproduct.cfm?partnumber=AC508-300-B | thorlabs | AC508-300-B | AC508-300-B.jpg |  |  |  | tube lens
 |  |  |  | SM2AD30 - SM2-Threaded Mounting Adapter for Ø30 mm Optics | 1 | 29.61 | https://www.thorlabs.com/thorproduct.cfm?partnumber=SM2AD30 | thorlabs | SM2AD30 | SM2AD30.jpg |  |  |  | adapter to insert AC300-050-B into LM2XY
 |  |  |  | AC300-050-B - f=50.0 mm, Ø30.0 mm Achromatic Doublet, ARC: 650-1050 nm | 1 | 93.33 | https://www.thorlabs.com/thorproduct.cfm?partnumber=AC300-050-B | thorlabs | AC300-050-B | AC300-050-B.jpg |  |  |  | scan lens
 |  |  |  | MA45-2 - 45° Mounting Adapter, Compatible with KM100 and KM200, 8-32 and 1/4"-20 Taps | 1 | 21.52 | https://www.thorlabs.com/thorproduct.cfm?partnumber=MA45-2 | thorlabs | MA45-2 | MA45-2.jpg
 |  |  |  | AC300-050-B - f=50.0 mm, Ø30.0 mm Achromatic Doublet, ARC: 650-1050 nm | 1 | 93.33 | https://www.thorlabs.com/thorproduct.cfm?partnumber=AC300-050-B | thorlabs | AC300-050-B | AC300-050-B.jpg |  |  |  | scan lens
 |  |  |  | AC300-080-B - f=80.0 mm, Ø30.0 mm Achromatic Doublet, ARC: 650-1050 nm | 1 | 93.33 | https://www.thorlabs.com/thorproduct.cfm?partnumber=AC300-080-B | thorlabs | AC300-080-B
 |  |  |  | AC-508-300B: f=300.0 mm, Ø2" Achromatic Doublet, ARC: 650-1050 nm | 1 | 134.64 | https://www.thorlabs.com/thorproduct.cfm?partnumber=AC508-300-B | thorlabs | AC | AC508-300-B.jpg |  |  |  | tube lens
 |  |  |  | LA1708-A - N-BK7 Plano-Convex Lens, Ø1", f = 200.0 mm, AR Coating: 350-700 nm | 1 | 30.60 | https://www.thorlabs.com/thorproduct.cfm?partnumber=LA1708-A | thorlabs | LA1708-A | LA1708-A.jpg |  |  |  | red channel (should be, but is it really there?)
 |  |  |  | LA1027-A - N-BK7 Plano-Convex Lens, Ø1", f = 35.0 mm, AR Coating: 350-700 nm | 1 | 34.00 | https://www.thorlabs.com/thorproduct.cfm?partnumber=LA1027-A | thorlabs | LA1027-A | LA1027-A.jpg |  |  |  | red channel PMT
 |  |  |  | LA1951-A - N-BK7 Plano-Convex Lens, Ø1", f = 25.4 mm, AR Coating: 350-700 nm | 1 | 35.00 | https://www.thorlabs.com/thorproduct.cfm?partnumber=LA1951-A | thorlabs | LA1951-A | LA1951-A.jpg
 |  |  |  | AC254-045-B - f=45.0 mm, Ø1" Achromatic Doublet, ARC: 650-1050 nm | 1 | 89.00 | https://www.thorlabs.com/thorproduct.cfm?partnumber=AC254-045-B | thorlabs | AC254-045-B | AC254-045-B.jpg
 |  |  |  | AC254-125-B - f=125.0 mm, Ø1" Achromatic Doublet, ARC: 650-1050 nm | 1 | 89.00 | https://www.thorlabs.com/thorproduct.cfm?partnumber=AC254-125-B | thorlabs | AC254-125-B | AC254-125-B.jpg
 |  | > |  | AC254-100-B - f = 100.0 mm, Ø1" Achromatic Doublet, ARC: 650 - 1050 nm | 1 | 94.42 | https://www.thorlabs.com/thorproduct.cfm?partnumber=AC254-100-B | thorlabs | AC254-100-B | AC254-100-B.jpg
 |  |  |  | P50D - Ø1" Mounted Precision Pinhole, 50 ± 3 µm Pinhole Diameter | 1 | 69.53 | https://www.thorlabs.com/thorproduct.cfm?partnumber=P50D | thorlabs | P50D | P50D.jpg |  |  |  | The precision pinhole to clean up the gaussian fs beam. 40um is a better fit, but there is no high-power version of that pinhole at Thorlabs, which might be required.
 |  |  |  | UFBS5050 - Ø1" 50:50 (R:T) Low-GDD Ultrafast Beamsplitter, 600 - 1500 nm, 45° AOI | 1 | 260.10 | https://www.thorlabs.com/thorproduct.cfm?partnumber=UFBS5050 | thorlabs | UFBS5050 | UFBS5050.jpg
 |  |  |  | AHWP05M-980 - Ø1/2" Mounted Achromatic Half-Wave Plate, Ø1" Mount, 690 - 1200 nm | 1 | 839.43 | https://www.thorlabs.com/thorproduct.cfm?partnumber=AHWP05M-980 | thorlabs | AHWP05M-980 | AHWP05M-980.jpg
 |  |  |  | AHWP10M-980 - Ø1" Mounted Achromatic Half-Wave Plate, SM1-Threaded Mount, 690 - 1200 nm | 1 | 884.00 | https://www.thorlabs.com/thorproduct.cfm?partnumber=AHWP10M-980 | thorlabs | AHWP10M-980 | AHWP10M-980.jpg
 | >
 |  |  |  | Misc:
 |  |  |  | BS017 - 50:50 Non-Polarizing Beamsplitter Cube, 700-1100 nm, 20 mm | 1 | 197.88 | https://www.thorlabs.com/thorproduct.cfm?partnumber=BS017 | thorlabs | BS017 | BS017.jpg |  |  |  | 50:50 beam splitter (might be different size..)
 |  |  |  | AHWP10M-980 - Ø1" Mounted Achromatic Half-Wave Plate, SM1-Threaded Mount, 690 - 1200 nm | 1 | 884.00 | https://www.thorlabs.com/thorproduct.cfm?partnumber=AHWP10M-980 | thorlabs | AHWP10M-980 | AHWP10M-980.jpg
 |  |  |  | GL10-B Mounted Glan-Laser Polarizer, Ø10 mm CA, AR Coating: 650 - 1050 nm | 1 | 806.00 | https://www.thorlabs.com/thorproduct.cfm?partnumber=GL10-B | thorlabs | GL10-B | GL10-B.jpg
 |  |  |  | Ø25 mm BG39 Colored Glass Bandpass Filter, 360 - 580 nm (max transmission of ~86% at 500nm) | 1 | 25.00 | https://www.thorlabs.com/thorproduct.cfm?partnumber=FGB39 | thorlabs | FGB39 | FGB39.jpg |  |  |  | the usefulness of this filter that it transmits <1e-5 light in 820-940nm and <2e-5 in 940-980nm
 |  |  |  | LB1 - Beam Block, 400 - 700 nm, 10 W Max Avg. Power, CW Only, Includes TR3 Post | 1 | 50.49 | https://www.thorlabs.com/thorproduct.cfm?partnumber=LB1 | thorlabs | LB1 | LB1.jpg |  |  |  | ! Note that it's actually designed for visible CW light (400-700nm). The more appropriate is BT610 ($300).
 |  |  |  | BTC30 - 30 mm Cage-Compatible, Quick-Release Beam Trap, 5 W Max Avg. Power, CW Only | 1 | 219.67 | https://www.thorlabs.com/thorproduct.cfm?partnumber#BTC30 | thorlabs | BTC30
 | Power meters <
 |  | Consoles <
 |  |  |  | PM100D - Compact Power and Energy Meter Console, Digital 4" LCD | 1 | 1075.00 | https://www.thorlabs.com/thorproduct.cfm?partnumber=PM100D | thorlabs | PM100D | PM100D.jpg
 |  | > |  | PM102 - Thermal Sensor Interface with USB, RS232, UART, and Analog Operation | 1 | 484.00 | https://www.thorlabs.com/thorproduct.cfm?partnumber=PM102 | thorlabs | PM102 | PM102.jpg |  |  |  | There are still cheaper (by about $30) options with less connector interfaces.
 |  | Power sensors <
 |  |  |  | S405C - Thermal Power Sensor Head, Surface Absorber, 0.19 - 20 µm, 5 W, Ø10 mm | 1 | 746.87 | https://www.thorlabs.com/thorproduct.cfm?partnumber=S405C | thorlabs | S405C | S405C.jpg
 |  |  |  | PM16-405 - USB Power Meter, Thermal Sensor, 0.19 - 20 µm, 5 W Max | 1 | 1050.00 | https://www.thorlabs.com/thorproduct.cfm?partnumber=PM16-405 | thorlabs | PM16-405 | PM16-405.jpg
 |  |  |  | S130C - Slim Photodiode Power Sensor, Si, 400 - 1100 nm, 500 mW | 1 | 508.98 | https://www.thorlabs.com/thorproduct.cfm?partnumber=S130C | thorlabs | S130C | S130C.jpg
 |  |  |  | PM16-130 - USB Power Meter, Slim Photodiode Sensor, Si, 400 - 1100 nm, 500 mW Max | 1 | 848.00 | https://www.thorlabs.com/thorproduct.cfm?partnumber=PM16-130 | thorlabs | PM16-130 | PM16-130.jpg
 |  |  |  | S310C - Thermal Power Sensor Head, Surface Absorber, 0.19 - 25 µm, 10 W, Ø20 mm | 1 | obsolete | https://www.thorlabs.com/thorproduct.cfm?partnumber=S310C | thorlabs | S310C | S310C.jpg |  |  |  | previously: $740.
 |  | > |  | SM1A29 - SM1 Thread Adapter for Slim Photodiode Sensors | 1 | 44.64 | https://www.thorlabs.com/thorproduct.cfm?partnumber=SM1A29 | thorlabs | SM1A29 | SM1A29.jpg
 | Opto-electronics <
 |  |  |  | ELL14K - Rotation Mount Bundle: ELL14 Mount, Interface Board, Power Supply, Cables | 1 | 546.93 | https://www.thorlabs.com/thorproduct.cfm?partnumber=ELL14K | thorlabs | ELL14K | ELL14K.jpg
 |  |  |  | KDC101 - K-Cube Brushed DC Servo Motor Controller (Power Supply Not Included) | 1 | 639.00 | https://www.thorlabs.com/thorproduct.cfm?partnumber=KDC101 | thorlabs | KDC101 | KDC101.jpg
 |  |  |  | KPS101 - 15 V, 2.4 A Power Supply Unit with 3.5 mm Jack Connector for One K- or T-Cube | 1 | 33.00 | https://www.thorlabs.com/thorproduct.cfm?partnumber=KPS101 | thorlabs | KPS101 | KPS101.jpg
 |  |  |  | PRM1Z8 - Ø1" Motorized Precision Rotation Stage (Imperial) | 1 | 909.00 | https://www.thorlabs.com/thorproduct.cfm?partnumber=PRM1Z8 | thorlabs | PRM1Z8 | PRM1Z8.jpg
 |  |  |  | LEDD1B - T-Cube LED Driver, 1200 mA Max Drive Current (Power Supply Not Included) | 1 | 305.00 | https://www.thorlabs.com/thorproduct.cfm?partnumber=LEDD1B | thorlabs | LEDD1B | LEDD1B.jpg |  |  |  | The actual supply in the setup was probably DIY
 | > |  |  | M780L3 - 780 nm, 200 mW (Min) Mounted LED, 800 mA | 1 | 220.32 | https://www.thorlabs.com/thorproduct.cfm?partnumber=M780L3 | thorlabs | M780L3 | M780L3.jpg
>
Semrock <
 |  |  |  | Semrock FF735-Di01-25x36 (DISCONTINUED) - 735 nm edge BrightLine® multiphoton single-edge dichroic beamsplitter | 1 | 565.00 | https://www.semrock.com/FilterDetails.aspx?id=FF735-Di01-25x36 | semrock |  |  |  |  |  | pump/red channel dichroic
 |  |  |  | Semrock FF660-Di02-25x36 - 660 nm edge BrightLine® single-edge standard epi-fluorescence dichroic beamsplitter | 1 | 255.00 | https://www.semrock.com/FilterDetails.aspx?id=FF660-Di02-25x36 | semrock |  |  |  |  |  | red channel PMT/IR camera dichroic
 |  |  |  | Semrock FF562-Di03-25x36 - 562 nm edge BrightLine® single-edge standard epi-fluorescence dichroic beamsplitter | 1 | 255.00 | https://www.semrock.com/FilterDetails.aspx?id=FF562-Di03-25x36 | semrock |  |  |  |  |  | pump/green channel dichroic
> |  |  |  | Semrock FF01-514/30-25 (514/30 Nrightline bandpass filter, 25mm) | 1 | 355.00 | https://www.semrock.com/FilterDetails.aspx?id=FF01-514/30-25 | semrock
Chroma <
 |  |  |  | Chroma E700sp-2p8 69104 (aka Chroma E700SP-2P) | 1
> |  |  |  | Chroma ET750sp-2p8 -- short pass | 1 | 625.00 | https://www.chroma.com/products/single-bandpass-and-single-edge-filters/filter-type/shortpass-filters/type/parts_display | chroma |  |  |  |  |  | Not in the rig. A suggested replacement for E700sp-2p8. Blocks multiphoton lasers between 780-1064nm to = OD8 average and transmits between 400-745nm = 95% average
Uniblitz <
 |  |  |  | VS25 25mm Optical Shutter, VSR25S1T1 (Normally opened -- For use with D880C or VED24 drivers), un-housed, teflon coated, electronic sync -- yes, Connector : 7-pin, NO for the rest (default options)) | 1 | 485.00 | https://www.uniblitz.com/product/vs25-shutter-system/ | uniblitz |  |  |  |  |  | rush order for extra money
> |  |  |  | D880C Open Frame Uni-stable Driver | 1 | 500.00 | https://www.uniblitz.com/products/d880c-shutter-driver/ | uniblitz |  |  |  |  |  | lead time: 4-5 weeks
Hamamatsu <
 |  |  |  | Hamamatsu R3896 - PMT tube | 2 | 905.00 | https://www.hamamatsu.com/us/en/R3896.html | hamamatsu |  |  |  |  |  | manually selected at the factory for low noise
 |  |  |  | Hamamatsu C12597-01 - socket | 2 | 254.00 |  | hamamatsu |  |  |  |  |  | No associated page. Only the specs PDF
> |  |  |  | Hamamatsu C6438 - wide bandwidth amplifier unit |  | 522.00 |  | hamamatsu |  |  |  |  |  | ! Haven't used yet. See emails from 6/15/15
Newport
 |  |  |  | Research Grade Optical Table, 1200 x 2400 x 203 mm, Metric M6 Holes, Model: M-RS2000-48-8 | 1 | 5500.00 | https://www.newport.com/p/M-RS2000-48-8 | newport | M-RS2000-48-8 |  |  |  |  | Table in Duke. At Harvard the table is of same size.
 |  |  |  | ULTRAlign Linear Stage, 25 mm X Travel, Crossed-Roller Bearings, 8-32 & 1/4-20 | 1 | 674.00 | https://www.newport.com/p/462-X-M | newport | 462-X-M
 |  |  |  | Integrated Crossed-Roller Bearing XY Linear Stage, ULTRAlign, 1.0 in. (model 462-XY-M) | 1 | 1024.00 | https://www.newport.com/p/462-XY-M | newport | 462-XY-M
 |  |  |  | Compact Linear Stage, 25 mm Travel, 100 nm MIM, DC Servo with Tach, Metric | 1 | 5196.00 | https://www.newport.com/p/M-VP-25XA | newport | M-VP-25XA
 |  |  |  | Newport ESP301-3G | 1 | 4778.00 | https://www.newport.com/f/esp301-3-axis-dc-and-stepper-motion-controller | newport | ESP301-3G |  |  |  |  | Also driving the vertical stage actuator (see detector)
 |  |  |  | Newport CMA-25cccl (obsolete). Replaced by:
 |  |  |  | Newport TRB25CC -- Compact Motorized Actuator, 25 mm Travel, DC Servo Motor, 90N | 1 | 1107.00 | https://www.newport.com/p/TRB25CC | newport | TRB25CC
 |  |  |  | Newport ESP300-J joystick | 1 | 567.00 | https://www.newport.com/p/ESP300-J | newport | ESP300-J |  |  |  |  | none-critical
 |  |  |  | Achromatic Waveplate, Half-Wave, Quartz-MgF2, 25.4 mm, 700-1000 nm | 1 | 897.00 | https://www.newport.com/p/10RP52-2B | newport | 10RP52-2B
 |  |  |  | Motorized Rotation Stage, Compact, 360°, DC Servo Motor | 1 | 1803 | https://www.newport.com/p/PR50CC | newport | PR50CC
 |  |  |  | Motion Controller, Single-axis DC Motor. | 1 | 1038 | https://www.newport.com/p/SMC100CC | newport | SMC100CC
 |  |  |  | Motion Controller Card, Universal, Stepper, DC, and Linear Motors | 1 | 613.00 | https://www.newport.com/p/XPS-DRV11 | newport | XPS-DRV11
 |  |  |  | Power Supply, SMC100 Series, 80W, 100-240 VAC, 47-63 Hz, 1.9 A max. | 1 | 156.00 | https://www.newport.com/p/SMC-PS80 | newport | SMC-PS80
 |  |  |  | RS-232-C Cable, 3 m Length, DB9F to DB9F | 1 | 30.00 | https://www.newport.com/p/SMC-232 | newport | SMC-232
Edmund Optics
 |  |  |  | 6" Travel, 9"L x 2"W Ball Bearing Slide (Stock No. =37-366 ) | 1 | 325.00 | https://www.edmundoptics.com/optomechanics/translation-stages-slides/manual-stages-slides/6quot-travel-9quotl-x-2quotw-ball-bearing-slide/ | edmundoptics
 |  |  |  | Thermal Grease for Galvanometer Scanner (Optional) | 1 | 15.00 | https://www.edmundoptics.com/lasers/laser-mechanics/Thermal-Grease-for-Galvanometer-Scanner-Optional/ | edmundoptics
 |  |  |  | Tuning/Signal Monitoring Breakout Board for 6210H |  |  | https://www.edmundoptics.com/lasers/laser-mechanics/tuningsignal-monitoring-breakout-board-for-6210h/ | edmundoptics
Optotune
 |  |  |  | Optotune Electrically Focus-Tunable Lens EL-10-30, NIR Coated (=83-922) | 1 | 440.00 |  |  |  |  |  |  |  | Bought in Edmund Optics -- not available any more
 |  |  |  | Optotune Electrical Lens Driver (=88-940) | 1 | 280.00
Stanford Research systems
 |  |  |  | SR570 -- Stanford research systems preamp | 2 | 2600.00 | http://www.thinksrs.com/products/SR570.htm
Olympus
 |  | objective lenses <
 |  |  |  | Olympus, XLUMPLFLN20XW; SUPER 20X WATER NA 1.0,WD 2MM, 38 DEG ACCD 2MM | 1 | 6895.00 | https://www.olympus-lifescience.com/en/objectives/xlumplfln-w/=!cms[tab]=%2Fobjectives%2Fxlumplfln-w%2F20xw | olympus | XLUMPLFLN20XW |  |  |  |  | price: quote for Duke. Discount: 5%
 |  | > |  | Olympus, XLUMPLFLN20XW; SUPER 20X WATER NA 1.0,WD 2MM, 38 DEG ACCD 2MM | 1 | 7939.15 | https://www.thorlabs.com/thorproduct.cfm?partnumber=N20X-PFH | thorlabs | N20X-PFH |  |  |  |  | Same as from Olympus. More expensive, but readily available
Hitec
 |  |  |  | Hitec HS-422 Servo Motor | 1 | 10.00 | http://hitecrcd.com/products/servos/sport-servos/analog-sport-servos/hs-422-deluxe-standard-servo/product
Phidgets
 |  |  |  | Phidgets 1-motor controller | 1 | 35.00 | https://www.phidgets.com/?tier=3&catid=21&pcid=18&prodid=1044 |  |  |  |  |  |  | This link is to a replacement of the original detail. Note that substitution with teensy or Arduino is cheaper and better!
Basler
 |  |  |  | Basler scout scA1390-17fm camera, 17 FPS at 1.4 MP res, 1/2" CCD / Sony ICX267 sensor | 1 | 1300.00 | https://www.baslerweb.com/en/products/cameras/area-scan-cameras/scout/sca1390-17fm/ |  |  |  |  |  |  | price is approximate. The site is with tech info
Misc
 |  |  |  | ball caster with 1/4-20 threaded stud. | 2 | 23.62 | http://apollocaster.com/store/index.php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 |  |  |  |  |  |  | Here is one example
 |  |  |  | agilent e3620a -- power supply, 2 Output, 0 V, 25 V, 0 A, 1 A | 1 | 681.00 | http://www.newark.com/keysight-technologies/e3620a/power-supply-dc-bench-25v-50w/dp/91F3056
 |  |  |  | Optically Colored Cast Acrylic Sheet, 3/16" Thick, 12" x 12" | 1 | 8.00 | http://www.mcmaster.com/=8505k81/=13ybnus
Cambridge Tech (Novanta) <
 | Novanta orders <
 |  |  |  | Cambridge Tech 6210H galvo (3mm (6x5mm) mirrors) and 671 servo board | 1 | 1204.00 |  | Cambridge Tech | 6SD12047 | C:\data\Dropbox\rnd\manuals\galvos\CambridgeTech\Galvos\CambridgeTech_6210H_3mm-mirror.png | 12-16 weeks |  |  | SYS 1X, 3MM S1, 6210H, 671-1, 40 DEG OPT, +/-28V PS, +/-10V, CMD, 203CM CABLE, NOMNT (X)
 |  |  |  | Cambridge Tech 6215H galvo (7mm mirrors) and 671-HP servo board | 1 | 1682.00 |  | Cambridge Tech | 6SD11468 |  | 12-16 weeks |  |  | GALVO SET, 1X, 6215H, 671-HP, 07MM, X, S1, SI SLAB, 40 DEG OPT-PP, 200CM CABLE, +/-28V PS, +/-10V CMD
 |  |  |  | Cambridge Tech 6210H galvo, no mirror | 1 | 534.00 |  | Cambridge Tech | 6210HM40B |  |  |  |  | GALVO, 6210H, 40 DEG OPT-PP, 0 DEG SLOT, NO CABLE, MICRO AMP CONNECTOR
 |  |  |  | Cambridge Tech 6215H galvo with 7mm mirror | 1 | 796.00 |  | Cambridge Tech | 6SD12356 |  |  |  |  | GALVO-MIRROR, 1X, 7MM S1, 6215H, NOSRV, NOMNT (X)
 |  |  |  | 3mm mirror | 1 | 66.00 |  | Cambridge Tech | 6m2003X-S
 |  |  |  | 6210HM60B galvo scanner, AMP connector, ±15 mechanical degrees, ±30 optical degrees | 1 |  |  |  |  |  |  |  |  | Note that the actual scanner might have been ±10 degrees
 |  |  |  | 673xx Analog Servo Driver (2 axes) | 1 |  |  |  |  |  |  |  |  | The price is from a quote for 6220H galvanometers. 2550
 |  |  |  | Interconnect Cable, 2m | 2
 |  |  |  | 3mm XY Mount for the Model 6210H Galvanometer Scanner | 1
 | > |  |  | 3mm XY Mirror Set, S1 Protected Silver Coating | 1
 | Power supply <
 |  |  |  | AC-DC CONVERTER, 350W, INDUSTRIA : Enclosed AC DC Converter 1 Output 28V 12.5A 85 ~ 264 VAC Input | 1 | 107.00 | https://www.digikey.com/product-detail/en/xp-power/SMP350PS28/1470-4449-ND/7897369 | digikey | 1470-4449-ND | C:\data\Dropbox\rnd\microframe\pics\electronics\Industria AC-DC MFG_SMP350.jpg |  |  | SMP350PS28
 | > |  |  | Linear AC DC Converter, Bell, 115W, 2 Output 24V -24V 2.4A, 2.4A 100, 120, 220, 230, 240 VAC Input | 1 | 145.35 | https://www.digikey.com/product-detail/en/bel-power-solutions/HCC24-2.4-AG/179-2329-ND/1634184 | digikey | 179-2329-ND |  |  |  | HCC24-2.4-AG
 | Wiring <
 |  | power cables <
 |  |  |  | general digikey search |  |  | https://www.digikey.com/products/en/cables-wires/multiple-conductor-cables/473?k=WIRES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
 |  | > |  | Belden Inc. CABLE 5300FE 008500, 2COND 18AWG GRAY 100' | 1 | 33.50 | https://www.digikey.com/product-detail/en/belden-inc/5300FE-008500/BEL1268-100-ND/7042005 | digikey | BEL1268-100-ND |  |  |  | 5300FE 008500
 |  |  | power supply / servo board necessary components <
 |  | inline fuses <
 |  | > |  | 10pcs 5x20mm Fuse Holder Inline Screw Type With less than 18 AWG wire + 150pcs Quick Blow Glass Tube Fuse Assorted Kit Amp 250V 0.1A,0.2A,0.5A,1A,2A,3A,5A,8A,10A,15A,5x20mm, 250V 0.5A,1A,5A,10A,15A,6x30mm | 1 | 11.99 | https://www.amazon.com/gp/product/B07F8RLMPB/ref=ox_sc_act_title_1?smid=A3M2HBGA41EX9M&psc=1 | amazon |  |  |  |  |  | Need 3A, .., and 10A fuses for the galvo servo drives
 |  | Ring Insulated Electrical Wire Terminals Wire Crimp Connectors <
 |  |  |  | 22-16 AWG
 |  |  |  | 12-10 AWG
 |  | > |  | Glarks 540pcs 22-16/16-14/12-10 Gauge Mixed Quick Disconnect Electrical Insulated Butt Bullet Spade Fork Ring Solderless Crimp Terminals Connectors Assortment Kit | 1 | 18.66 | https://www.amazon.com/gp/product/B01E4RAVI0/ref=ppx_yo_dt_b_search_asin_title?ie=UTF8&psc=1 | amazon |  | Glarks 540pcs 22-10AWG terminals.jpg
 |  |  |  | heat-shrink tubes
 |  |  | >
 |  |  | 4 galvo servo boards enclosure < |  |  | 25.00
 |  |  |  | 3D printed enclosure | 1 |  |  | diy
 |  |  |  | any of the 120mm fans. The price is approximate. Consider quite choices. | 1 | 15.00
 |  |  | > | any of the 120mm fan guards in the search following the link | 1 | 10.00 | https://www.amazon.com/s?k=120+mm+fan+grill+guard&ref=nb_sb_noss_2 | amazon
 |  |  | spare (copies) electric components for those coming with the servo boards < |  |  | 2.14 |  |  |  |  |  |  |  | Cambridge Tech sends the exact number of components necessary to complete the wiring. If you miswire or want to change anything though, you need spares.
 |  |  |  | Molex 4 Rectangular Connectors - Housings Receptacle Black 0.100" (2.54mm) | 1 | 0.26 | https://www.digikey.com/product-detail/en/molex-llc/0050579404/WM2902-ND/115057 | digikey | WM2902-ND | C:\data\Dropbox\rnd\microframe\pics\electronics\Molex 50-57-9404.jpg |  |  | 0050579404 | command wires connector
 |  |  |  | Molex Socket Contact Gold 22-24 AWG Crimp | 3 | 0.18 | https://www.digikey.com/product-detail/en/molex/0016020103/WM2512-ND/115063 | digikey | WM2512-ND | C:\data\Dropbox\rnd\microframe\pics\electronics\Molex 0016020103.JPG |  |  | 0016020103 | command wires connector
 |  |  |  | Molex 4 Rectangular Connectors - Housings Receptacle Natural 0.200" (5.08mm) | 1 | 0.58 | https://www.digikey.com/products/en?keywords=Molex%20%23%2015-24-4048 | digikey | WM6982-ND | C:\data\Dropbox\rnd\microframe\pics\electronics\Molex 15-24-4048.jpg |  |  | 15244048 | power connector
> | > |  | > | Molex Socket Contact Tin 14-20 AWG Crimp Power | 4 | 0.19 | https://www.digikey.com/product-detail/en/molex/0002081201/WM2293CT-ND/2405710 | digikey | WM2293CT-ND | C:\data\Dropbox\rnd\microframe\pics\electronics\Molex 0002081201.jpg |  |  | 0002081201 | power connector; replacement for Molex = 02-08-1202 recommended in the servo manual.
 |  | microcircuits <
 |  |  |  | digikey search |  |  | https://www.digikey.com/products/en/development-boards-kits-programmers/evaluation-boards-embedded-mcu-dsp/786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 | digikey
 |  |  |  | Teensy 3.2 Development Board | 1 | 19.80 | https://www.pjrc.com/store/teensy32.html | pjrc | TEENSY32
 |  |  |  | Teensy 3.2 Development Board with soldered side pins | 1 | 20.80 | https://www.pjrc.com/store/teensy32_pins.html | pjrc | TEENSY32_PINS
 |  |  |  | Teensy 4.0 Development Board | 1 | 19.95 | https://www.pjrc.com/store/teensy40.html | pjrc | TEENSY40
 |  | > |  | Teensy 4.0 Development Board with soldered side pins | 1 | 22.95 | https://www.pjrc.com/store/teensy40_pins.html | pjrc | TEENSY40_PINS
 | motors <
 |  | servos <
 |  |  |  | Hitec HS-422 Servo Motor | 1 | 11.49 | https://www.servocity.com/hs-422-servo | servocity | 31422S |  |  |  | hitecrcd (https://hitecrcd.com/products/servos/sport-servos/analog-sport-servos/hs-422/product)
 |  | >
 |  | stepper motors <
 | > | >
 | pulleys <
 |  |  |  | O-Ring Pulleys, 1" | 1 | 5.99 | https://www.servocity.com/smooth-hub-pulleys | servocity | 615130
 |  |  |  | O-Ring Pulleys, 2" | 1 | 7.99 | https://www.servocity.com/smooth-hub-pulleys | servocity | 615134
 |  |  |  | O-Ring Pulleys, 3" | 1 | 9.99 | https://www.servocity.com/smooth-hub-pulleys | servocity | 615138
 |  |  |  | 1/8" O-Ring Belts, 3.5" | 1 | 0.69 | https://www.servocity.com/0-125-1-8-o-ring-belts | servocity | 636120
 | > |  |  | 1/8" O-Ring Belts, different length |  |  | https://www.servocity.com/0-125-1-8-o-ring-belts | servocity
 | Pockels cells <
Conoptics <
 |  |  | Conoptics M350-80-LA + 302RM < |  |  | 11250 |  |  |  |  |  |  |  | sold with 10% educational discount to this price
 |  |  |  | model 350-80-LA-02-RP KD*P series E-O modulator with 3.5mm aperture and removable output polarizer | 1 | 5100 |  | conoptics |  |  | 6 |  |  | has a low dispersion at 1um
 |  |  |  | model 302RM driver, DC-to-250KHz Bandwidth, 1us Rise/Fall, 750V | 1 | 5300 |  | conoptics |  |  | 6
> | > |  | > | BK option used to minimize piezo-electric resonanses for model 350 series | 1 | 850 |  | conoptics |  |  | 6
Holoeye <
 | SLMs < |  |  |  |  | 15500
 |  |  | Holoeye SLM asmbly <
 |  |  |  | Driver Unit | 1 | 11300
 |  |  |  | PLUTO-2-NIR-015 phase only SLM - display | 1 | 4200
> |  |  | > | M2 screws | 3 |  | https://www.mcmaster.com/91290A015
Meadowlark <
 |  |  | Meadowlark SLM asmbly <
 | > |  | >

Sheet: common
cat2 | cat1 | swap-in | Assembly | Part name | Qty | Price ea, $ | url | vendor | catalog # | pic | lead time | extra info | Notes
mirrors <
 | mirrors for <12mm beams and 1" mounts <
 |  | ultrafast mirror, beam<1/2" <
 |  |  | mounted 1/2"mirror < |  |  | 82.84
 |  |  |  | AD1 - Ø1" OD Adapter for Ø1/2" Optic, 0.25" Thick | 1 | 16.56 | https://www.thorlabs.com/thorproduct.cfm?partnumber=AD1 | thorlabs | AD1
 |  | > | > | UM05-AG - Ø1/2" Ultrafast-Enhanced Silver Mirror, 750 - 1000 nm | 1 | 66.28 | https://www.thorlabs.com/thorproduct.cfm?partnumber=UM05-AG | thorlabs | UM05-AG
 |  |  | right angle, 30mm cage mirror < |  |  | 195.02
 |  |  |  | KCB1 - Right-Angle Kinematic Mirror Mount with Tapped Cage Rod Holes, 30 mm Cage System and SM1 Compatible, 8-32 and 1/4"-20 Mounting Holes | 1 | 143.00 | https://www.thorlabs.com/thorproduct.cfm?partnumber=KCB1 | thorlabs | KCB1
 |  |  | > | PF10-03-P01 - Ø1" Protected Silver Mirror | 1 | 52.02 | https://www.thorlabs.com/thorproduct.cfm?partnumber=PF10-03-P01 | thorlabs | PF10-03-P01 |  |  |  | reflectance >97.5% for 450 nm - 2 µm (-P01)
 |  |  | KCB1+UM10-AG - right angle, 30mm cage, ultrafast mirror < |  |  | 247.97 |  |  |  | KCB1+UM10-AG - right angle_30mm cage_ultrafast mirror.png
 |  |  |  | KCB1 - Right-Angle Kinematic Mirror Mount with Tapped Cage Rod Holes, 30 mm Cage System and SM1 Compatible, 8-32 and 1/4"-20 Mounting Holes | 1 | 143.00 | https://www.thorlabs.com/thorproduct.cfm?partnumber=KCB1 | thorlabs | KCB1
 |  |  | > | UM10-AG - Ø1" Ultrafast-Enhanced Silver Mirror, 750 - 1000 nm | 1 | 104.97 | https://www.thorlabs.com/thorproduct.cfm?partnumber=UM10-AG | thorlabs | UM10-AG | 0 |  | 0 | reflectance >97.5% for 450 nm - 2 µm (-P01)
 |  |  | KCB1C+UM10-AG - right angle, rod bores, 30mm cage, ultrafast mirror < |  |  | 252.26 |  |  |  | KCB1C+UM10-AG - right angle_rod bores_30mm cage_ultrafast mirror.png
 |  |  |  | KCB1C - Right-Angle Kinematic Mirror Mount with Smooth Cage Rod Bores, 30 mm Cage System and SM1 Compatible, 8-32 and 1/4"-20 Mounting Holes | 1 | 147.29 | https://www.thorlabs.com/thorproduct.cfm?partnumber=KCB1C#ad-image-0 | thorlabs | KCB1C | KCB1C.jpg | 0 | 0
 |  |  | > | UM10-AG - Ø1" Ultrafast-Enhanced Silver Mirror, 750 - 1000 nm | 1 | 104.97 | https://www.thorlabs.com/thorproduct.cfm?partnumber=UM10-AG | thorlabs | UM10-AG | 0 |  | 0 | reflectance >97.5% for 450 nm - 2 µm (-P01)
 |  |  | 2" mounted mirror: KCB2C + PF20-03-01 < |  |  | 275.00
 |  |  |  | KCB2C - Right-Angle Kinematic Mirror Mount with Smooth Cage Rod Bores, 60 mm Cage System and SM2 Compatible, 8-32 and 1/4"-20 Mounting Holes | 1 | 168.92 | https://www.thorlabs.com/thorproduct.cfm?partnumber=KCB2C | thorlabs | KCB2C |  |  |  |  | A more flexible choice than KCB2, as it allows connecting the cubes directly, without LCP01
 |  |  | > | PF20-03-P01 - Ø2" Protected Silver Mirror | 1 | 106.08 | https://www.thorlabs.com/thorproduct.cfm?partnumber=PF20-03-P01 | thorlabs | PF20-03-P01
 | posts < |  | 1.5" post assembly < |  |  | 12.19
 |  |  |  | PH1.5 - Ø1/2" Post Holder, Spring-Loaded Hex-Locking Thumbscrew, L = 1.5" | 1 | 7.22 | https://www.thorlabs.com/thorproduct.cfm?partnumber=PH1.5 | thorlabs | PH1.5 | PH1.5.jpg |  | 0
 |  |  | > | TR1.5 - Ø1/2" Optical Post, SS, 8-32 Setscrew, 1/4"-20 Tap, L = 1.5" | 1 | 4.97 | https://www.thorlabs.com/thorproduct.cfm?partnumber=TR1.5 | thorlabs | TR1.5 | TR1.5.jpg |  | 0
 |  |  | 2" post assembly < |  |  | 12.89
 |  |  |  | PH2 - Ø1/2" Post Holder, Spring-Loaded Hex-Locking Thumbscrew, L = 2" | 1 | 7.70 | https://www.thorlabs.com/thorproduct.cfm?partnumber=PH2 | thorlabs | PH2 | PH2.jpg |  | 0
 |  |  | > | TR2 - Ø1/2" Optical Post, SS, 8-32 Setscrew, 1/4"-20 Tap, L = 2" | 1 | 5.19 | https://www.thorlabs.com/thorproduct.cfm?partnumber=TR2 | thorlabs | TR2 | TR2.jpg |  | 0
 |  |  | 3" post assembly < |  |  | 13.69
 |  |  |  | PH3 - Ø1/2" Post Holder, Spring-Loaded Hex-Locking Thumbscrew, L = 3" | 1 | 8.27 | https://www.thorlabs.com/thorproduct.cfm?partnumber=PH3=ad-image-0 | thorlabs | PH3
 |  |  | > | TR3 - Ø1/2" Optical Post, SS, 8-32 Setscrew, 1/4"-20 Tap, L = 3" | 1 | 5.42 | https://www.thorlabs.com/thorproduct.cfm?partnumber=TR3 | thorlabs | TR3
 |  |  | 2" post assembly with short base < |  |  | 18.09
 |  |  |  | 2" post assembly < | 1 | 12.89
 |  |  | > | BA1S - Mounting Base, 1" x 2.3" x 3/8" | 1 | 5.20 | https://www.thorlabs.com/thorproduct.cfm?partnumber=BA1S | thorlabs | BA1S
 |  |  | 3" post assembly with short base < |  |  | 18.89
 |  |  |  | 3" post assembly < | 1 | 13.69
 |  |  | > | BA1S - Mounting Base, 1" x 2.3" x 3/8" | 1 | 5.20 | https://www.thorlabs.com/thorproduct.cfm?partnumber=BA1S | thorlabs | BA1S
 |  |  | 4" post assembly, pedestal mounted < |  |  | 36.50
 |  |  |  | PH4 - Ø1/2" Post Holder, Spring-Loaded Hex-Locking Thumbscrew, L = 4" | 1 | 9.45 | https://www.thorlabs.com/thorproduct.cfm?partnumber=PH4#ad-image-0 | thorlabs | PH4 | 0 | 0 | 0
 |  |  |  | TR4 - Ø1/2" Optical Post, SS, 8-32 Setscrew, 1/4"-20 Tap, L = 4" | 1 | 5.87 | https://www.thorlabs.com/thorproduct.cfm?partnumber=TR4 | thorlabs | TR4 | TR4.jpg | 0 | 0
 |  |  |  | BE1 - Ø1.25" Studded Pedestal Base Adapter, 1/4"-20 Thread | 1 | 9.49 | https://www.thorlabs.com/thorproduct.cfm?partnumber#BE1-P5 | thorlabs | BE1 | 0 | 0 | 0
 | > |  | > | CF125C - Clamping Fork, 1.24" Counterbored Slot, 1/4"-20 Captive Screw | 1 | 11.69 | https://www.thorlabs.com/thorproduct.cfm?partnumber=CF125C#ad-image-0 | thorlabs | CF125C | 0 | 0 | 0
 | dichroic housing <
 |  |  | dichroic, 30mm cube, housing common < |  |  | 190.19 |  |  |  | dichroic_30mm cube_housing common.png
 |  |  |  | B4C - Kinematic Cage Cube Platform for C4W/C6W | 1 | 98.43 | https://www.thorlabs.com/thorproduct.cfm?partnumber#B4C | thorlabs | B4C
 |  |  |  | FFM1 - 30-mm-Cage-Compatible Rectangular Filter Mount | 1 | 58.40 | https://www.thorlabs.com/thorproduct.cfm?partnumber#FFM1 | thorlabs | FFM1
 |  |  |  | B1C - Blank Cover Plate | 1 | 18.77 | https://www.thorlabs.com/thorproduct.cfm?partnumber#B1C | thorlabs | B1C
 |  |  | > | SM1PL - Externally SM1-Threaded Plug | 1 | 14.59 | https://www.thorlabs.com/thorproduct.cfm?partnumber#SM1PL | thorlabs | SM1PL
 |  |  | 30mm cage dichroic housing, rods through < |  |  | 253.94 |  |  |  | 30mm cage dichroic housing_rods through.png
 |  |  |  | C6W - 30 mm Cage Cube, Ø6 mm Through Holes | 1 | 63.75 | https://www.thorlabs.com/thorproduct.cfm?partnumber=C6W | thorlabs | C6W | C6W.jpg | 0 | 0
 |  |  | > | dichroic, 30mm cube, housing common < | 1 | 190.19 |  |  |  | dichroic_30mm cube_housing common.png
 |  |  | 30mm cage dichroic housing, rods end < |  |  | 250.63 |  |  |  | 30mm cage dichroic housing_rods end.png
 |  |  |  | C4W - 30 mm Cage Cube | 1 | 60.44 | https://www.thorlabs.com/thorproduct.cfm?partnumber=C4W | thorlabs | C4W | C4W.jpg | 0 | 0
 | > |  | > | dichroic, 30mm cube, housing common < | 1 | 190.19 |  |  |  | dichroic_30mm cube_housing common.png
 |  |  | Cambridge Tech, 6210H 3 mm galvo, 671 servo < |  |  | 1509.29
 |  |  |  | Cambridge Tech 6210H galvo (3mm (6x5mm) mirrors) and 671 servo board | 1 | 1204.00
 |  |  |  | AC-DC CONVERTER, 350W, INDUSTRIA : Enclosed AC DC Converter 1 Output 28V 12.5A 85 ~ 264 VAC Input | 2 | 107.00 |  |  | 0 | 0 | 0 | 30mm cage dichroic housing_rods end.png | 0 | 0
 |  |  |  | Belden Inc. CABLE 5300FE 008500, 2COND 18AWG GRAY 100' | 1 | 33.50
 |  |  |  | 10pcs 5x20mm Fuse Holder Inline Screw Type With less than 18 AWG wire + 150pcs Quick Blow Glass Tube Fuse Assorted Kit Amp 250V 0.1A,0.2A,0.5A,1A,2A,3A,5A,8A,10A,15A,5x20mm, 250V 0.5A,1A,5A,10A,15A,6x30mm | 1 | 11.99
 |  |  |  | Glarks 540pcs 22-16/16-14/12-10 Gauge Mixed Quick Disconnect Electrical Insulated Butt Bullet Spade Fork Ring Solderless Crimp Terminals Connectors Assortment Kit | 1 | 18.66
 |  |  |  | 4 galvo servo boards enclosure < | 1 | 25.00
 |  |  | > | spare (copies) electric components for those coming with the servo boards < | 1 | 2.14
 | variable length 4-ER-rod connectors <
 |  |  | ER-rod connection_4-7in < |  |  | 48.19 |  |  |  | ER-rod connector_4-7in_v1.png
 |  |  |  | CP08 - SM1-Threaded 30 mm Cage Plate with Flexure Clamping, 1 Retaining Ring, 8-32 Tap | 1 | 19.79 | https://www.thorlabs.com/thorproduct.cfm?partnumber=CP08 | thorlabs | CP08 | CP08.jpg |  | 0
 |  |  | > | ER4 - Cage Assembly Rod, 4" Long, Ø6 mm | 4 | 7.10 | https://www.thorlabs.com/thorproduct.cfm?partnumber=ER4 | thorlabs | ER4 | ER4.jpg |  | 0
 |  |  | ER-rod connection_2-3.5in < |  |  | 44.19 |  |  |  | ER-rod connector_2-3.5in_v1.png
 |  |  |  | CP08 - SM1-Threaded 30 mm Cage Plate with Flexure Clamping, 1 Retaining Ring, 8-32 Tap | 1 | 19.79 | https://www.thorlabs.com/thorproduct.cfm?partnumber=CP08 | thorlabs | CP08 | CP08.jpg |  | 0
 |  |  | > | ER2 - Cage Assembly Rod, 2" Long, Ø6 mm | 4 | 6.10 | https://www.thorlabs.com/thorproduct.cfm?partnumber=ER2 | thorlabs | ER2 | ER2.jpg |  | 0
 |  |  | Cambridge Tech 6210H mounted in C6W < |  |  | 2471.75
 |  |  |  | Cambridge Tech 6210H with 3mm (6x5mm) 6110 mirror and cables | 1 | 2408.00 |  | Cambridge Tech | 6SD12047 |  | 12-16 |  |  | SYS 1X, 3MM S1, 6210H, 671-1, 40 DEG OPT, +/-28V PS, +/-10V, CMD, 203CM CABLE, NOMNT (X)
 |  |  |  | C6W - 30 mm Cage Cube, Ø6 mm Through Holes | 1 | 63.75 | https://www.thorlabs.com/thorproduct.cfm?partnumber=C6W | thorlabs | C6W | C6W.jpg | 0 | 0
 |  |  | > | Cambridge Tech 6210H mounted in C6W DIY parts | 1

Sheet: pre-scanner
cat3 | cat2 | cat1 | cat0 | swap-in | Assembly | Part name | Qty | Price ea, $ | url | vendor | catalog # | pic | lead time | extra info | Notes
telescopes <
 |  |  |  |  | laser telescope 1 < |  |  | 412.83 |  |  |  |  |  |  | Adjusts the beam diameter to fit the required aperture (e.g., dictated by the size of the galvo mirrors).
 |  |  |  |  |  | CP35 - 30 mm Cage Plate with Ø1" Double Bore, 8-32 Tap | 2 | 18.68 | https://www.thorlabs.com/thorproduct.cfm?partnumber=CP35 | thorlabs | CP35 | CP35.jpg |  | 0
 |  |  |  |  |  | AC254-045-B - f=45.0 mm, Ø1" Achromatic Doublet, ARC: 650-1050 nm | 1 | 89.00 | https://www.thorlabs.com/thorproduct.cfm?partnumber=AC254-045-B | thorlabs | AC254-045-B | AC254-045-B.jpg |  | 0 | This choice of lenses increases the beam from about 1.1mm (diameter of our output laser beam to 3mm in diameter (galvo mirror size).
 |  |  |  |  |  | AC254-125-B - f=125.0 mm, Ø1" Achromatic Doublet, ARC: 650-1050 nm | 1 | 89.00 | https://www.thorlabs.com/thorproduct.cfm?partnumber=AC254-125-B | thorlabs | AC254-125-B | AC254-125-B.jpg |  | 0
 |  |  |  |  |  | CP20S - 30 mm Cage System Iris, Ø20.0 mm Maximum Aperture | 1 | 88.00 | https://www.thorlabs.com/thorproduct.cfm?partnumber=CP20S | thorlabs | CP20S | CP20S.jpg |  | 0 | The main purpose is to narrow the beam during the alignment, but can also be used to remove the unwanted glare (especially, if no precision "beam cleaning" pinhole is used.
 |  |  |  |  |  | 3" post assembly with short base < | 1 | 18.89
 |  |  |  |  |  | ER10 - Cage Assembly Rod, 10" Long, Ø6 mm | 4 | 12.70 | https://www.thorlabs.com/thorproduct.cfm?partnumber=ER10 | thorlabs | ER10
 |  |  |  |  |  | LCP02 - 30 mm to 60 mm Cage Plate Adapter, 8-32 Tap | 1 | 39.78 | https://www.thorlabs.com/thorproduct.cfm?partnumber=LCP02 | thorlabs | LCP02 | LCP02.jpg |  | 0
 |  |  |  |  | > | ER2-P4 - Cage Assembly Rod, 2" Long, Ø6 mm, 4 Pack | 1 | 23.18 | https://www.thorlabs.com/thorproduct.cfm?partnumber=ER2-P4 | thorlabs | ER2-P4 | ER2-P4.jpg |  | 0
 |  |  |  |  | laser telescope 2 < |  |  | 530.68 |  |  |  | telescope_asmbly1.png |  |  | Adjusts the beam diameter to fit the required aperture (e.g., dictated by the size of the galvo mirrors).
 |  |  |  |  |  | AC254-045-B - f=45.0 mm, Ø1" Achromatic Doublet, ARC: 650-1050 nm | 1 | 89.00 | https://www.thorlabs.com/thorproduct.cfm?partnumber=AC254-045-B | thorlabs | AC254-045-B | AC254-045-B.jpg |  | 0 | This choice of lenses increases the beam from about 1.3mm (diameter of our output laser beam) to 3mm in diameter (galvo mirror size).
 |  |  |  |  |  | AC254-100-B - f = 100.0 mm, Ø1" Achromatic Doublet, ARC: 650 - 1050 nm | 1 | 94.42 | https://www.thorlabs.com/thorproduct.cfm?partnumber=AC254-100-B | thorlabs | AC254-100-B | AC254-100-B.jpg | 0 | 0
 |  |  |  |  |  | SPT1 - Coarse ±1 mm XY Slip Plate Positioner, 30 mm Cage Compatible | 2 | 66.55 | https://www.thorlabs.com/thorproduct.cfm?partnumber=SPT1 | thorlabs | SPT1 | SPT1.jpg |  | 0
 |  |  |  |  |  | SM1L03 - SM1 Lens Tube, 0.30" Thread Depth, One Retaining Ring Included | 1 | 12.16 | https://www.thorlabs.com/thorproduct.cfm?partnumber=SM1L03 | thorlabs | SM1L03 | SM1L03.jpg |  | 0
 |  |  |  |  |  | SM1L05 - SM1 Lens Tube, 0.50" Thread Depth, One Retaining Ring Included | 1 | 12.59 | https://www.thorlabs.com/thorproduct.cfm?partnumber=SM1L05 | thorlabs | SM1L05 | SM1L05.jpg |  | 0
 |  |  |  |  |  | CP20S - 30 mm Cage System Iris, Ø20.0 mm Maximum Aperture | 1 | 88.00 | https://www.thorlabs.com/thorproduct.cfm?partnumber=CP20S | thorlabs | CP20S | CP20S.jpg |  | 0 | The main purpose is to narrow the beam during the alignment, but can also be used to remove the unwanted glare (especially, if no precision "beam cleaning" pinhole is used.
 |  |  | rods < |  |  | ER10 - Cage Assembly Rod, 10" Long, Ø6 mm | 3 | 12.70 | https://www.thorlabs.com/thorproduct.cfm?partnumber=ER10 | thorlabs | ER10 | ER10.jpg | 0 | 0
 |  |  | > |  |  | ER8 - Cage Assembly Rod, 8" Long, Ø6 mm | 1 | 12.05 | https://www.thorlabs.com/thorproduct.cfm?partnumber=ER8 | thorlabs | ER8 | ER8.jpg | 0 | 0
 |  |  | mounting < |  |  | CP35 - 30 mm Cage Plate with Ø1" Double Bore, 8-32 Tap | 1 | 18.68 | https://www.thorlabs.com/thorproduct.cfm?partnumber=CP35 | thorlabs | CP35 | CP35.jpg |  | 0
 |  |  |  |  |  | 3" post assembly < | 1 | 13.69 |  |  |  | 0.00
 |  |  | > |  | > | 3" post assembly with short base < | 1 | 18.89 |  |  |  | 0.00
 |  |  | spacial filters <
 |  |  |  |  | precision pinhole < |  |  | 269.32 |  |  |  | mounted_precision-pinhole_50um_xy-mount.png |  |  | The telescope is a natural place to position the precision pinhole to spacially filter the incoming laser beam to get a more Gaussian beam as a result.
 |  |  |  |  |  | CXY1 - 30 mm Cage System, XY Translating Lens Mount for Ø1" Optics | 1 | 187.20 | https://www.thorlabs.com/thorproduct.cfm?partnumber=CXY1=ad-image-0 | thorlabs | CXY1 | CXY1.jpg |  | 0
 |  |  |  |  |  | SM1L05 - SM1 Lens Tube, 0.50" Thread Depth, One Retaining Ring Included | 1 | 12.59 | https://www.thorlabs.com/thorproduct.cfm?partnumber=SM1L05 | thorlabs | SM1L05 | SM1L05.jpg |  | 0
> |  |  | > |  | > | P50D - Ø1" Mounted Precision Pinhole, 50 ± 3 µm Pinhole Diameter | 1 | 69.53 | https://www.thorlabs.com/thorproduct.cfm?partnumber=P50D | thorlabs | P50D | P50D.jpg |  | 0 | The precision pinhole to clean up the gaussian fs beam. 40um is a better fit, but there is no high-power version of that pinhole at Thorlabs, which might be required.
rig beam splitter <
 |  |  |  |  | cube beam splitter < |  |  | 292.13
 |  |  |  |  |  | BS017 - 50:50 Non-Polarizing Beamsplitter Cube, 700-1100 nm, 20 mm | 1 | 197.88 | https://www.thorlabs.com/thorproduct.cfm?partnumber=BS017 | thorlabs | BS017 |  |  |  | 50:50 beam splitter (might be different size..)
 |  |  |  |  |  | KM100PM - Kinematic Prism Mount, 1.00" Deep, 6-32 Taps | 1 | 75.48 | https://www.thorlabs.com/thorproduct.cfm?partnumber=KM100PM | thorlabs | KM100PM |  |  |  | most likely this model..
 |  |  |  |  | > | PM3 - Small Adjustable Clamping Arm, 6-32 Threaded Post | 1 | 18.77 | https://www.thorlabs.com/thorproduct.cfm?partnumber=PM3 | thorlabs | PM3 |  |  |  | In the rig -- discontinued PM2
 |  |  |  |  | plate beamsplitter, 30mm cage system < |  |  | 405.50 |  |  |  |  |  |  |  | `
 |  |  |  |  |  | CP35 - 30 mm Cage Plate with Ø1" Double Bore, 8-32 Tap | 1 | 18.68 | https://www.thorlabs.com/thorproduct.cfm?partnumber=CP35 | thorlabs | CP35
 |  |  |  |  |  | CP360R - Pivoting, Quick-Release, Ø1" Optic Mount for 30 mm Cage System | 1 | 95.63 | https://www.thorlabs.com/thorproduct.cfm?partnumber=CP360R | thorlabs | CP360R | CP360R.jpg |  | 0
 |  |  |  |  |  | UFBS5050 - Ø1" 50:50 (R:T) Low-GDD Ultrafast Beamsplitter, 600 - 1500 nm, 45° AOI | 1 | 260.10 | https://www.thorlabs.com/thorproduct.cfm?partnumber=UFBS5050 | thorlabs | UFBS5050 | UFBS5050.jpg |  | 0
 |  |  |  |  |  | ER2 - Cage Assembly Rod, 2" Long, Ø6 mm | 2 | 6.10 | https://www.thorlabs.com/thorproduct.cfm?partnumber=ER2 | thorlabs | ER2 | ER2.jpg |  | 0
> |  |  |  |  | > | 3" post assembly with short base < | 1 | 18.89
power controller <
 |  | Power meters <
 |  |  |  | 30 mm cage mountable asmblies <
 |  |  |  |  |  | PM16-405 - USB Power Meter, Thermal Sensor, 0.19 - 20 µm, 5 W Max | 1 | 1050.00 | https://www.thorlabs.com/thorproduct.cfm?partnumber=PM16-405 | thorlabs | PM16-405 | PM16-405.jpg |  | 0
 |  |  |  |  | power meter, without display, Thorlabs < |  |  | 1230.87
 |  |  |  |  |  | S405C - Thermal Power Sensor Head, Surface Absorber, 0.19 - 20 µm, 5 W, Ø10 mm | 1 | 746.87 | https://www.thorlabs.com/thorproduct.cfm?partnumber=S405C | thorlabs | S405C | S405C.jpg |  | 0
 |  |  |  |  | > | PM102 - Thermal Sensor Interface with USB, RS232, UART, and Analog Operation | 1 | 484.00 | https://www.thorlabs.com/thorproduct.cfm?partnumber=PM102 | thorlabs | PM102 | PM102.jpg |  | 0
 |  |  |  |  | power meter, with display, Thorlabs < |  |  | 1821.87
 |  |  |  |  |  | S405C - Thermal Power Sensor Head, Surface Absorber, 0.19 - 20 µm, 5 W, Ø10 mm | 1 | 746.87 | https://www.thorlabs.com/thorproduct.cfm?partnumber=S405C | thorlabs | S405C | S405C.jpg |  | 0
 |  |  |  |  | > | PM100D - Compact Power and Energy Meter Console, Digital 4" LCD | 1 | 1075.00 | https://www.thorlabs.com/thorproduct.cfm?partnumber=PM100D | thorlabs | PM100D | PM100D.jpg |  | 0
 |  |  |  |  | diy power meter, without microcircuit <
 |  |  |  |  |  | "Wire Glue" electrically conductive glue | 1
 |  |  |  |  |  | TEC (Peltier Thermoelectric Cooler Module) with high Q | 1
 |  |  |  |  |  | heat sink | 1
 |  |  |  | > | > | heat sink - 30mm cage system adapter + case | 1 |  |  | diy
 |  |  |  |  | power meter with display 1-asmbly for attenuator < |  |  | 1883.47 |  |  |  | power meter-attenuator asmbly.png |  |  | Notice that the power meter used in this assembly has swap-in replacements
 |  |  |  |  |  | power meter, with display, Thorlabs < | 1 | 1821.87
 |  |  |  |  |  | CP30 - 30 mm to 30 mm Cage System Right-Angle Adapter | 1 | 51.50 | https://www.thorlabs.com/thorproduct.cfm?partnumber=CP30 | thorlabs | CP30 | CP30.jpg |  | 0
 |  | > |  |  | > | ER1 - Cage Assembly Rod, 1" Long, Ø6 mm | 2 | 5.05 | https://www.thorlabs.com/thorproduct.cfm?partnumber=ER1 | thorlabs | ER1 | ER1.jpg |  | 0
 |  | Pockels cell-based power controller <
 |  |  | Conoptics Pockels cell-based power controller <
 |  |  |  |  | Conoptics M350-80-LA + 302RM < |  |  | 11250
 |  |  |  |  |  | model 350-80-LA-02-RP KD*P series E-O modulator with 3.5mm aperture and removable output polarizer | 1 | 5100 | 0 | conoptics | 0 | 0 |  | 0
 |  |  |  |  |  | model 302RM driver, DC-to-250KHz Bandwidth, 1us Rise/Fall, 750V | 1 | 5300 | 0 | conoptics | 0 | 0 |  | 0
 |  |  |  |  | > | BK option used to minimize piezo-electric resonanses for model 350 series | 1 | 850 | 0 | conoptics | 0 | 0 |  | 0
 |  |  |  |  | Conoptics M350-80-LA + 302RM 30mm cage system mount < |  |  | 253.84
 |  |  |  |  |  | LCP02 - 30 mm to 60 mm Cage Plate Adapter, 8-32 Tap | 2 | 42.2 | https://www.thorlabs.com/thorproduct.cfm?partnumber=LCP02 | thorlabs | LCP02
 |  |  |  |  |  | SPT2 - Coarse ±2 mm Slip Plate Positioner for 60 mm Cage System | 2 | 71.03 | https://www.thorlabs.com/thorproduct.cfm?partnumber=SPT2 | thorlabs | SPT2
 |  | > | > |  | > | 3" post assembly < | 2 | 13.69 | 0.00 | 0.00 | 0.00 | 0.00 |  | 0.00
 | Glan-polarizer based asmblies <
 |  | Glan-polarizer asmbly <
 |  |  |  | Glan-laser polarizer mounted for 30mm cage system <
 |  |  |  |  | GL10-B based mounted polarizer < |  |  | 859.00
 |  |  |  |  |  | GL10-B Mounted Glan-Laser Polarizer, Ø10 mm CA, AR Coating: 650 - 1050 nm | 1 | 806.00 | https://www.thorlabs.com/thorproduct.cfm?partnumber=GL10-B | thorlabs | GL10-B | GL10-B.jpg | 0 | 0
 |  |  |  |  | > | SM1PM10 - SM1 Lens Tube Mount for 8 mm and 10 mm Mounted Polarizing Prisms | 1 | 53.00 | https://www.thorlabs.com/thorproduct.cfm?partnumber=SM1PM10 | thorlabs | SM1PM10 | SM1PM10.jpg | 0 | 0
 |  |  |  |  | GL5-B based mounted polarizer < |  |  | 785.03
 |  |  |  |  |  | GL5-B - Mounted Glan-Laser Polarizer, Ø5 mm CA, AR Coating: 650 - 1050 nm | 1 | 712.03 | https://www.thorlabs.com/thorproduct.cfm?partnumber=GL5-B | thorlabs | GL5-B
 |  |  |  |  |  | SM05PM5 - SM05 Lens Tube Mount for 5 mm Mounted Polarizing Prisms | 1 | 52.22 | https://www.thorlabs.com/thorproduct.cfm?partnumber=SM05PM5 | thorlabs | SM05PM5
 |  |  |  |  | > | SM1A6 - Adapter with External SM1 Threads and Internal SM05 Threads, 0.15" Thick | 1 | 20.78 | https://www.thorlabs.com/thorproduct.cfm?partnumber=SM1A6 | thorlabs | SM1A6
 |  |  |  |  | Edmund optics < |  |  | 770.00
 |  |  |  |  |  | Glan-Laser Polarizer 350 - 2300nm, 8mm | 1 | 770.00 | https://www.edmundoptics.com/p/glan-laser-polarizer-350-2200nm-8mm/32020/ | edmund optics | 89-551 |  |  |  | 25.4mm in diameter, 24.5mm in length. No threads. Can be held, e.g., in an SM1L.. tube. But how can it be secured?
 |  |  |  | > | > | …
 |  |  |  |  | Glan-polarizer rotatable asmbly, 5mm -1 < |  |  | 872.42 |  |  |  | Glan-polarizer asmbly 5mm.png
 |  |  |  |  |  | GL5-B based mounted polarizer < | 1 | 785.03 | 0.00 | 0 | 0 | 0.00 |  | 0.00
 |  |  |  |  | > | CRM1 - Cage Rotation Mount for Ø1" Optics, SM1 Threaded, 8-32 Tap | 1 | 87.39 | https://www.thorlabs.com/thorproduct.cfm?partnumber=CRM1 | thorlabs | CRM1 | CRM1.jpg |  | 0
 |  |  |  |  | Glan-polarizer rotatable asmbly, 10mm -1 < |  |  |  |  |  |  | Glan-polarizer asmbly 10mm.png
 |  |  |  |  |  | GL10-B based mounted polarizer < | 1 | 859.00 |  |  |  | 0
 |  | > |  |  | > | CRM1 - Cage Rotation Mount for Ø1" Optics, SM1 Threaded, 8-32 Tap | 1 | 87.39 | https://www.thorlabs.com/thorproduct.cfm?partnumber=CRM1 | thorlabs | CRM1 | CRM1.jpg | 0 | 0
 |  | waveplates <
 |  |  |  | half-wave plate asmbly mountable in CRM1 < |  |  |  |  |  |  |  |  |  |  | Note that the wave plates listed here are chosen to allow for a broadband wavelength range and have a high damage threshold. If these can be relaxed, other materials, such as quartz zero-order half waveplates, or achromatic polymers, can also be used.
 |  |  |  |  |  | AHWP05M-980 - Ø1/2" Mounted Achromatic Half-Wave Plate, Ø1" Mount, 690 - 1200 nm | 1 | 839.43 | https://www.thorlabs.com/thorproduct.cfm?partnumber=AHWP05M-980 | thorlabs | AHWP05M-980 | AHWP05M-980.jpg
 |  |  |  |  |  | AHWP10M-980 - Ø1" Mounted Achromatic Half-Wave Plate, SM1-Threaded Mount, 690 - 1200 nm | 1 | 884.00 | https://www.thorlabs.com/thorproduct.cfm?partnumber=AHWP10M-980 | thorlabs | AHWP10M-980 | AHWP10M-980.jpg
 |  | > |  | > |  | Achromatic Waveplate, Half-Wave, Quartz-MgF2, 25.4 mm, 700-1000 nm | 1 | 897.00 | https://www.newport.com/p/10RP52-2B | newport | 10RP52-2B | 0 |  | 0
 |  | 1" optics rotator <
 |  |  | DIY rotator <
 |  |  |  |  | rotator pulley system < |  |  | 14.67
 |  |  |  |  |  | O-Ring Pulleys, 1" | 1 | 5.99 | https://www.servocity.com/smooth-hub-pulleys | servocity | 615130 | 0 |  | 0
 |  |  |  |  |  | O-Ring Pulleys, 2" | 1 | 7.99 | https://www.servocity.com/smooth-hub-pulleys | servocity | 615134 | 0 |  | 0
 |  |  |  |  |  | 1/8" O-Ring Belts, 3.5" | 1 | 0.69 | https://www.servocity.com/0-125-1-8-o-ring-belts | servocity | 636120 | 0 |  | 0
 |  |  |  |  | > | pulley-30mm cage system adapter | 1 |  |  | diy |  | CRM1-pulley adapter_v1.png
 |  |  |  |  | table mounted servo < |  |  | 34.44 |  |  |  | table mounted servo hs-422_v3.png
 |  |  |  |  |  | Hitec HS-422 Servo Motor | 1 | 11.49 | https://www.servocity.com/hs-422-servo | servocity | 31422S | 0 |  | 0
 |  |  |  |  |  | Hitec HS-422 servo table mount | 1 |  |  | diy |  | servo table mount_v3.png
 |  |  |  |  | > | Teensy 4.0 Development Board with soldered side pins | 1 | 22.95 | https://www.pjrc.com/store/teensy40_pins.html | pjrc | TEENSY40_PINS | 0 |  | 0 | teensy 3 through 4 (maybe, newer as well)
 |  |  |  |  | diy rotator < |  |  | 69.31
 |  |  |  |  |  | rotator pulley system < | 1 | 14.67
 |  |  |  |  |  | table mounted servo < | 1 | 34.44
 |  |  |  |  | > | ER1 - Cage Assembly Rod, 1" Long, Ø6 mm | 4 | 5.05 | https://www.thorlabs.com/thorproduct.cfm?partnumber=ER1 | thorlabs | ER1 | ER1.jpg |  | 0
 |  |  |  |  | diy 1" optics rotator < |  |  | 156.70 |  |  |  | 1in optics rotator_diy1.png
 |  |  |  |  |  | diy rotator < | 1 | 69.31
 |  |  | > |  | > | CRM1 - Cage Rotation Mount for Ø1" Optics, SM1 Threaded, 8-32 Tap | 1 | 87.39 | https://www.thorlabs.com/thorproduct.cfm?partnumber=CRM1 | thorlabs | CRM1 | CRM1.jpg |  | 0
 |  |  | Off-the-shelf 1" optics rotators <
 |  |  |  |  | Thorlabs off-the-shelf 1" optics rotator 1 < |  |  | 546.93
 |  |  |  |  |  | ELL14K - Rotation Mount Bundle: ELL14 Mount, Interface Board, Power Supply, Cables | 1 | 546.93 | https://www.thorlabs.com/thorproduct.cfm?partnumber=ELL14K | thorlabs | ELL14K | ELL14K.jpg |  | 0
 |  |  |  |  | > | ELL14 enclosure | 1 |  |  | diy
 |  |  |  |  | Thorlabs off-the-shelf 1" optics rotator 2 < |  |  | 1581.00
 |  |  |  |  |  | PRM1Z8 - Ø1" Motorized Precision Rotation Stage (Imperial) | 1 | 909.00 | https://www.thorlabs.com/thorproduct.cfm?partnumber=PRM1Z8 | thorlabs | PRM1Z8 | PRM1Z8.jpg |  | 0
 |  |  |  |  |  | KDC101 - K-Cube Brushed DC Servo Motor Controller (Power Supply Not Included) | 1 | 639.00 | https://www.thorlabs.com/thorproduct.cfm?partnumber=KDC101 | thorlabs | KDC101 | KDC101.jpg |  | 0
 |  |  |  |  | > | KPS101 - 15 V, 2.4 A Power Supply Unit with 3.5 mm Jack Connector for One K- or T-Cube | 1 | 33.00 | https://www.thorlabs.com/thorproduct.cfm?partnumber=KPS101 | thorlabs | KPS101 | KPS101.jpg |  | 0
 |  |  |  |  | Newport off-the-shelf 1" optics rotator < |  |  | 3198.00
 |  |  |  |  |  | Motorized Rotation Stage, Compact, 360°, DC Servo Motor | 1 | 1803.00 | https://www.newport.com/p/PR50CC | newport | PR50CC | 0 |  | 0 | Note that the central apperture is threaded 1.063-20 in., which is different from Thorlabs' SM1, which is 1.063-40 in., and so, isn't compatible with AHWP10M-XXX, but is with AHWP05M-XXX
 |  |  |  |  |  | Motion Controller, Single-axis DC Motor. | 1 | 1038.00 | https://www.newport.com/p/SMC100CC | newport | SMC100CC | 0 |  | 0
 |  |  |  |  |  | Power Supply, SMC100 Series, 80W, 100-240 VAC, 47-63 Hz, 1.9 A max. | 1 | 156.00 | https://www.newport.com/p/SMC-PS80 | newport | SMC-PS80 | 0 |  | 0
 |  |  |  |  |  | Power Supply, SMC100 Series, 80W, 100-240 VAC, 47-63 Hz, 1.9 A max. | 1 | 156.00 | https://www.newport.com/p/SMC-PS80 (https://www.newport.com/p/SMC-232) | newport | SMC-PS80 | 0 |  | 0
 |  |  |  |  |  | RS-232-C Cable, 3 m Length, DB9F to DB9F | 1 | 30.00 | https://www.newport.com/p/SMC-232 | newport | SMC-232 | 0 |  | 0
 |  | > | > |  | > | RS-232 to usb adapter | 1 | 15.00 | https://www.amazon.com/s?k=rs232+to+usb | amazon
 |  | Full asmbly <
 |  |  | Glan Prism + Half-waveplate + powermeter + rotator + mount asmbly <
 |  |  |  |  | Thorlabs, motorized, off-the-shelf-parts power controller < |  |  | 5046.33
 |  |  |  |  |  | power variator, Thorlabs < | 1 | 3224.46
 |  |  |  |  | > | power meter, with display, Thorlabs < | 1 | 1821.87
 |  |  |  |  | half-waveplate + Glan-polarizer + diy controller < |  |  | 3812.86 |  |  |  | power-controller-4_v4.png
 |  |  |  |  |  | half-waveplate + Glan-polarizer diy 1 < | 1 | 1894.95
 |  |  |  |  |  | power meter with display 1-asmbly for attenuator < | 1 | 1883.47
 |  |  |  |  | > | diy rotator < | 1 | 34.44
 |  |  |  |  | power variator, Thorlabs < |  |  | 3224.46
 |  |  |  |  |  | Thorlabs off-the-shelf 1" optics rotator 2 < | 1 | 1581.00
 |  |  |  |  |  | AHWP05M-980 - Ø1/2" Mounted Achromatic Half-Wave Plate, Ø1" Mount, 690 - 1200 nm | 1 | 839.43 | https://www.thorlabs.com/thorproduct.cfm?partnumber=AHWP05M-980 | thorlabs | AHWP05M-980 | AHWP05M-980.jpg |  | 0
 |  |  |  |  |  | GL5-B based mounted polarizer < | 1 | 785.03
 |  |  |  |  | > | SMR1 - Ø1" Lens Mount with SM1 Internal Threads and No Retaining Lip, 8-32 Tap | 1 | 19.00 | https://www.thorlabs.com/thorproduct.cfm?partnumber=SMR1 | thorlabs | SMR1
 |  |  |  |  | attenuator based on Glan Polarizer only < |  |  | 843.35 |  |  |  | attenuator-based-on-Glan-polarizer-only.png
 |  |  |  |  |  | GL10-B - Mounted Glan-Laser Polarizer, Ø10 mm CA, AR Coating: 650 - 1050 nm | 1 | 806.00 | https://www.thorlabs.com/thorproduct.cfm?partnumber=GL10-B | thorlabs | GL10-B
 |  |  |  |  |  | Hitec HS-422 Servo Motor | 1 | 11.49 | https://www.servocity.com/hs-422-servo | servocity | 31422S | 0 |  | 0 | other servos of the same formfactor would work as well
 |  |  |  |  |  | R16ZZ Shielded Bearing 1 x 2 x 1/2 inch Ball Bearings | 1 | 7.77 | https://www.amazon.com/gp/product/B002BBGD48/ref=ppx_od_dt_b_detailpages00?ie=UTF8&psc=1 | amazon | B002BBGD48 |  |  |  | Only size matters: unspsc code: 31171504.
 |  |  |  |  |  | acrilic | 1
 |  |  |  |  | > | 2" post assembly with short base < | 1 | 18.09
 |  |  |  |  | Thorlabs parts assembly, Polarizing prism only < |  |  | 1352.33
 |  |  |  |  |  | PRM1GL10 - Ø1" High-Precision Rotation Mount with Polarizing Prism Mount | 1 | 334.09 | https://www.thorlabs.com/thorproduct.cfm?partnumber=PRM1GL10 | thorlabs | PRM1GL10
 |  |  |  |  |  | CPR1 - 30 mm Rotating Cage Segment Plate | 1 | 160.74 | https://www.thorlabs.com/thorproduct.cfm?partnumber=CPR1&pn=CPR1=13431 | thorlabs | CPR1
 |  |  |  |  |  | CP30 - 30 mm to 30 mm Cage System Right-Angle Adapter | 1 | 51.50 | https://www.thorlabs.com/thorproduct.cfm?partnumber=CP30 | thorlabs | CP30
 |  |  |  |  | > | GL10-B - Mounted Glan-Laser Polarizer, Ø10 mm CA, AR Coating: 650 - 1050 nm | 1 | 806.00 | https://www.thorlabs.com/thorproduct.cfm?partnumber=GL10-B | thorlabs | GL10-B
 |  |  |  |  | half-waveplate + Glan-polarizer diy 1 < |  |  | 1894.95 |  |  |  | power-controller-4_v4-b.png
 |  |  |  |  |  | Glan-polarizer rotatable asmbly, 5mm -1 < | 1 | 872.42 |  |  |  | Glan-polarizer asmbly 5mm.png
 |  |  |  |  |  | AHWP05M-980 - Ø1/2" Mounted Achromatic Half-Wave Plate, Ø1" Mount, 690 - 1200 nm | 1 | 839.43 |  |  |  | AHWP05M-980.jpg
 |  |  |  |  |  | diy 1" optics rotator < | 1 | 156.70 |  |  |  | 1in optics rotator_diy1.png
 |  |  |  |  |  | ER3 - Cage Assembly Rod, 3" Long, Ø6 mm | 4 | 6.60 | https://www.thorlabs.com/thorproduct.cfm?partnumber=ER3 | thorlabs | ER3 | ER3.jpg
 |  |  | > |  | > | 3" post assembly < | 2 | 13.69 |  |  |  | 0.00
 |  |  | Pockels cell asmbly <
 |  |  |  |  | Conoptics Pockels cell-based power controller, 30mm cage asmbly < |  |  | 11503.84
 |  |  |  |  |  | Conoptics M350-80-LA + 302RM < | 1 | 11250.00
> | > | > | > |  | > | Conoptics M350-80-LA + 302RM 30mm cage system mount < | 1 | 253.84
rig shutter <
 |  |  |  |  | rig shutter, diy1 < |  |  | 186.78
 |  |  |  |  |  | Hitec HS-422 Servo Motor | 1 | 11.49 | https://www.servocity.com/hs-422-servo | servocity | 31422S | 0 |  | 0 | other servos of the same formfactor would work as well
 |  |  |  |  |  | PF10-03-P01 - Ø1" Protected Silver Mirror | 1 | 52.02 | https://www.thorlabs.com/thorproduct.cfm?partnumber=PF10-03-P01 | thorlabs | PF10-03-P01 |  |  |  | reflectance >97.5% for 450 nm - 2 µm (-P01)
 |  |  |  |  |  | LB1 - Beam Block, 400 - 700 nm, 10 W Max Avg. Power, CW Only, Includes TR3 Post | 1 | 50.49 | https://www.thorlabs.com/thorproduct.cfm?partnumber=LB1 | thorlabs | LB1 |  |  |  | ! Note that it's actually designed for visible CW light (400-700nm). The more appropriate is BT610 ($300).
 |  |  |  |  |  | Phidgets 1-motor controller | 1 | 35.00 | https://www.phidgets.com/?tier=3&catid=21&pcid=18&prodid=1044 | phidgets | 1066_1B |  |  |  | This link is to a replacement of the original detail. Note that substitution with teensy or Arduino is cheaper and better!
 |  |  |  |  |  | DIY acrylic mirror holder | 1
 |  |  |  |  | > | 3" post assembly with short base < | 2 | 18.89
 |  |  |  |  | rig shutter, diy2 < |  |  | 132.89
 |  |  |  |  |  | Hitec HS-422 Servo Motor | 1 | 11.49 | https://www.servocity.com/hs-422-servo | servocity | 31422S | 0 |  | 0 | other servos of the same formfactor would work as well
 |  |  |  |  |  | PF10-03-P01 - Ø1" Protected Silver Mirror | 1 | 52.02 | https://www.thorlabs.com/thorproduct.cfm?partnumber=PF10-03-P01 | thorlabs | PF10-03-P01 |  |  |  | reflectance >97.5% for 450 nm - 2 µm (-P01)
 |  |  |  |  |  | LB1 - Beam Block, 400 - 700 nm, 10 W Max Avg. Power, CW Only, Includes TR3 Post | 1 | 50.49 | https://www.thorlabs.com/thorproduct.cfm?partnumber=LB1 | thorlabs | LB1 |  |  |  | ! Note that it's actually designed for visible CW light (400-700nm). The more appropriate is BT610 ($300).
 |  |  |  |  |  | teensy
 |  |  |  |  |  | DIY acrylic mirror holder | 1
 |  |  |  |  | > | 3" post assembly with short base < | 1 | 18.89
 |  |  |  |  | rig shutter, 5W beam block, diy3 < |  |  | 302.07
 |  |  |  |  |  | Hitec HS-422 Servo Motor | 1 | 11.49 | https://www.servocity.com/hs-422-servo | servocity | 31422S | 0 | 0 | 0 | other servos of the same formfactor would work as well
 |  |  |  |  |  | PF10-03-P01 - Ø1" Protected Silver Mirror | 1 | 52.02 | https://www.thorlabs.com/thorproduct.cfm?partnumber=PF10-03-P01 | thorlabs | PF10-03-P01 |  |  |  | reflectance >97.5% for 450 nm - 2 µm (-P01)
 |  |  |  |  |  | BTC30 - 30 mm Cage-Compatible, Quick-Release Beam Trap, 5 W Max Avg. Power, CW Only | 1 | 219.67 | https://www.thorlabs.com/thorproduct.cfm?partnumber#BTC30 | thorlabs | BTC30 | 0 | 0 | 0 | ! Note that it's actually designed for visible CW light (400-700nm). The more appropriate is BT610 ($300).
 |  |  |  |  |  | teensy | 1
 |  |  |  |  |  | DIY acrylic mirror holder | 1
> |  |  |  |  | > | 3" post assembly with short base < | 1 | 18.89
laser output steering mirrors <
 |  |  |  |  | pre-rig steering mirrors, post mounted < |  |  | 217.62
 |  |  |  |  |  | KM100 - Kinematic Mirror Mount for Ø1" Optics | 2 | 38.70 | https://www.thorlabs.com/thorproduct.cfm?partnumber=KM100=ad-image-0 | thorlabs | KM100
 |  |  |  |  |  | PF10-03-P01 - Ø1" Protected Silver Mirror | 2 | 52.02 | https://www.thorlabs.com/thorproduct.cfm?partnumber=PF10-03-P01 | thorlabs | PF10-03-P01 |  |  |  | reflectance >97.5% for 450 nm - 2 µm (-P01)
 |  |  |  |  | > | 2" post assembly with short base < | 2 | 18.09
 |  |  |  |  | horizontal periscope, 30mm cage < |  |  | 471.26
 |  |  |  |  |  | right angle, 30mm cage mirror < | 2 | 195.02
 |  |  |  |  |  | ER3 - Cage Assembly Rod, 3" Long, Ø6 mm | 4 | 6.60 | https://www.thorlabs.com/thorproduct.cfm?partnumber=ER3 | thorlabs | ER3
 |  |  |  |  |  | CP4S - SM1-Threaded 30 mm Cage Plate, 4 mm Thick | 1 | 18.64 | https://www.thorlabs.com/thorproduct.cfm?partnumber=CP4S | thorlabs | CP4S
 |  |  |  |  | > | 2" post assembly with short base < | 2 | 18.09
 |  |  |  |  | laser steering mirror < |  |  | 213.91
 |  |  |  |  |  | right angle, 30mm cage mirror < | 1 | 195.02
 |  |  |  |  | > | 3" post assembly with short base < | 1 | 18.89
 |  | <
 |  |  |  |  | DT12-adjustable base on rail w magnetic base < |  |  | 148.68
 |  |  |  |  |  | RC1 - Dovetail Rail Carrier, 1.00" x 1.00" (25.4 mm x 25.4 mm), 1/4" (M6) Counterbore | 1 | 25.40 | https://www.thorlabs.com/thorproduct.cfm?partnumber=RC1 | thorlabs | RC1
 |  |  |  |  |  | DT12 - 1/2" Dovetail Translation Stage, 8-32 Taps | 1 | 84.14 | https://www.thorlabs.com/thorproduct.cfm?partnumber=DT12 | thorlabs | DT12
 |  |  |  |  | > | KBB1X1 - Bottom Plate Only of the KB1X1 Kinematic Base, =8 Counterbore | 1 | 39.14 | https://www.thorlabs.com/thorproduct.cfm?partnumber=KBB1X1 | thorlabs | KBB1X1
 |  |  |  |  | right-angle-30mm-mount_on 1.5mm post w magnetic base < |  |  | 299.30
 |  |  |  |  |  | KBT1X1 - Top Plate Only of the KB1X1 Kinematic Base, =8 Counterbore | 1 | 39.14 | https://www.thorlabs.com/thorproduct.cfm?partnumber=KBT1X1 | thorlabs | KBT1X1
 |  |  |  |  |  | 1.5" post assembly < | 1 | 12.19
 |  |  |  |  | > | KCB1+UM10-AG - right angle, 30mm cage, ultrafast mirror < | 1 | 247.97
 |  |  |  |  | laser output - 1 magnetic swappable, 2 positions, 90deg mirror, v.1 < |  |  | 658.93
 |  |  |  |  |  | right-angle-30mm-mount_on 1.5mm post w magnetic base < | 1 | 299.30
 |  |  |  |  |  | DT12-adjustable base on rail w magnetic base < | 2 | 148.68
 |  |  |  |  |  | RLA0600 - Dovetail Optical Rail, 6", Imperial | 1 | 43.10 | https://www.thorlabs.com/thorproduct.cfm?partnumber=RLA0600 | thorlabs | RLA0600
 |  |  |  |  | > | CL6 - Table Clamp, RLA Series Optical Rails | 3 | 6.39 | https://www.thorlabs.com/thorproduct.cfm?partnumber=CL6 | thorlabs | CL6
 |  |  |  |  | 2 laser magnetic swappable outputs, v.1 < |  |  | 1317.86
 |  |  |  |  | > | laser output - 1 magnetic swappable, 2 positions, 90deg mirror, v.1 < | 2 | 658.93
> |  | >
beam path cover <
 |  |  |  |  | Aluminum Lens Tube Covers |  |  |  | https://www.thorlabs.com/newgrouppage9.cfm?objectgroup_id=11225
> |  |  |  |  |  |  |  |  | https://www.thorlabs.com/newgrouppage9.cfm?objectgroup_id=3394
Full pre-rig assemblies <
 |  |  |  |  | pre-rig assembly 1 < |  |  | 2008.48
 |  |  |  |  |  | laser steering mirror < | 1 | 213.91
 |  |  |  |  |  | plate beamsplitter, 30mm cage system < | 1 | 405.50
 |  |  |  |  |  | laser telescope 1 < | 1 | 412.83
 |  |  |  |  |  | attenuator based on Glan Polarizer only < | 1 | 843.35
> |  |  |  |  | > | rig shutter, diy2 < | 1 | 132.89
 |  |  |  |  | prism dispersion compensation
 |  |  |  |  |  | 47-278, Edmund Optics

Sheet: upper-kinematic
cat0 | Assembly | Part name | Qty | Price ea, $ | url | vendor | catalog # | pic | lead time, weeks | extra info | Notes
vertical breadboard <
 | 12"x12" vertical board < |  |  | 276.46 |  |  |  | 12inx12in vertical board.png
 |  | MB12 - Aluminum Breadboard 12" x 12" x 1/2", 1/4"-20 Taps | 1 | 151.00 | https://www.thorlabs.com/thorproduct.cfm?partnumber=MB12 | thorlabs | MB12
 | > | VB01B - 18" Vertical Bracket for Breadboards, 1/4"-20 Holes, 1 Piece | 1 | 125.46 | https://www.thorlabs.com/thorproduct.cfm?partnumber=VB01B | thorlabs | VB01B | VB01B.jpg |  | 0
 | 12"x18" vertical board < |  |  | 313.46 |  |  |  | 12inx18in vertical board.png
 |  | MB1218 - Aluminum Breadboard 12" x 18" x 1/2", 1/4"-20 Taps | 1 | 188.00 | https://www.thorlabs.com/thorproduct.cfm?partnumber=MB1218 | thorlabs | MB1218 | MB1218.jpg |  | 0
> | > | VB01B - 18" Vertical Bracket for Breadboards, 1/4"-20 Holes, 1 Piece | 1 | 125.46 | https://www.thorlabs.com/thorproduct.cfm?partnumber=VB01B | thorlabs | VB01B | VB01B.jpg |  | 0
periscope <
 | periscope 2 arms -1 < |  |  | 635.68 |  |  |  | periscope_2arms-1_v5.png
 |  | ER-rod connection_4-7in < | 1 | 48.19 | 0.00 | 0.00 | 0.00 | ER-rod connector_4-7in_v1.png |  | 0.00
 |  | ER-rod connection_2-3.5in < | 1 | 44.19 | 0.00 | 0.00 | 0.00 | ER-rod connector_2-3.5in_v1.png |  | 0.00
 |  | KCB1+UM10-AG - right angle, 30mm cage, ultrafast mirror < | 1 | 247.97 | 0.00 | 0.00 | 0.00 | KCB1+UM10-AG - right angle_30mm cage_ultrafast mirror.png |  | 0.00
 |  | KCB1C+UM10-AG - right angle, rod bores, 30mm cage, ultrafast mirror < | 1 | 252.26 | 0.00 | 0.00 | 0.00 | KCB1C+UM10-AG - right angle_rod bores_30mm cage_ultrafast mirror.png | 0.00 | 0.00
 |  | 3" post assembly with short base < | 1 | 18.89 | 0.00 | 0.00 | 0.00 | 0.00 |  | 0.00
 |  | CP02B - 30 mm Cage Mounting Bracket | 1 | 14.08 | https://www.thorlabs.com/thorproduct.cfm?partnumber=CP02B | thorlabs | CP02B | CP02B.jpg |  | 0
 | > | ER1 - Cage Assembly Rod, 1" Long, Ø6 mm | 2 | 5.05 | https://www.thorlabs.com/thorproduct.cfm?partnumber=ER1 | thorlabs | ER1 | ER1.jpg |  | 0
 | periscope 3 arms -1 < |  |  | 931.84 |  |  |  | periscope_3arms-1_v12.png
 |  | ER-rod connection_4-7in < | 2 | 48.19 | 0.00 | 0.00 | 0.00 | ER-rod connector_4-7in_v1.png |  | 0.00
 |  | ER-rod connection_2-3.5in < | 1 | 44.19 | 0.00 | 0.00 | 0.00 | ER-rod connector_2-3.5in_v1.png |  | 0.00
 |  | KCB1+UM10-AG - right angle, 30mm cage, ultrafast mirror < | 2 | 247.97 | 0.00 | 0.00 | 0.00 | KCB1+UM10-AG - right angle_30mm cage_ultrafast mirror.png |  | 0.00
 |  | KCB1C+UM10-AG - right angle, rod bores, 30mm cage, ultrafast mirror < | 1 | 252.26 | 0.00 | 0.00 | 0.00 | KCB1C+UM10-AG - right angle_rod bores_30mm cage_ultrafast mirror.png | 0.00 | 0.00
 |  | 3" post assembly with short base < | 1 | 18.89 | 0.00 | 0.00 | 0.00 | 0.00 |  | 0.00
 |  | CP02B - 30 mm Cage Mounting Bracket | 1 | 14.08 | https://www.thorlabs.com/thorproduct.cfm?partnumber=CP02B | thorlabs | CP02B | CP02B.jpg |  | 0
> | > | ER1 - Cage Assembly Rod, 1" Long, Ø6 mm | 2 | 5.05 | https://www.thorlabs.com/thorproduct.cfm?partnumber=ER1 | thorlabs | ER1 | ER1.jpg |  | 0
 | vertical kinematics 1 < |  |  | 1208.30
 |  | 12"x12" vertical board < | 1 | 276.46 |  |  |  | 12inx12in vertical board.png
 | > | periscope 3 arms -1 < | 1 | 931.84 |  |  |  | periscope_3arms-1_v12.png
 | vertical kinematics 2 < |  |  | 949.14
 |  | 12"x18" vertical board < | 1 | 313.46 |  |  |  | 12inx18in vertical board.png
 | > | periscope 2 arms -1 < | 1 | 635.68 |  |  |  | periscope_2arms-1_v5.png
 | Vert column< | XT95-1500 - 95 mm Construction Rail, Clear Anodized, L = 1500 mm | 1 | 306.00 | https://www.thorlabs.com/thorproduct.cfm?partnumber=XT95-1500 | thorlabs | XT95-1500
 |  | XT95P3 - Base Plate for 95 mm Rails | 1 | 51.51 | https://www.thorlabs.com/thorproduct.cfm?partnumber=XT95P3 | thorlabs | XT95P3 |  |  |  | Main vertical column. ?Cut down to 4'?
 |  | XT95P11 - Drop-On Rail Carriage for 95 mm Rails, 1/4"-20 Tapped Holes | 1 | 83.39 | https://www.thorlabs.com/thorproduct.cfm?partnumber=XT95P11 | thorlabs | XT95P11 |  |  |  | For vertical mounting of 95 mm Rails
 | > | XT95P12 - Rail Plate for 95 mm Rails, 1/4"-20 Tapped Holes | 1 | 46.16 | https://www.thorlabs.com/thorproduct.cfm?partnumber=XT95P12 | thorlabs | XT95P12
 | <horiz rail> | XT66-500 - 66 mm Construction Rail, L = 500 mm | 1 | 85.43 | https://www.thorlabs.com/thorproduct.cfm?partnumber=XT66-500 | thorlabs | XT66-500
 |  | XT66C4 - Clamping Platform for 66 mm Rails, 1/4" Counterbored Slot, 40 mm Long | 2 | 28.56 | https://www.thorlabs.com/thorproduct.cfm?partnumber=XT66C4 | thorlabs | XT66C4 |  |  |  | Upper side-arm holding two translation mirrors
 | steering mirrors<
 | table upward mirror< | BA2 - Mounting Base, 2" x 3" x 3/8" | 1 | 7.30 | https://www.thorlabs.com/thorproduct.cfm?partnumber=BA2 | thorlabs | BA2
 |  | … attach h45 to tr2
 |  | PH2 - Ø1/2" Post Holder, Spring-Loaded Hex-Locking Thumbscrew, L = 2" | 1 | 7.70 | https://www.thorlabs.com/thorproduct.cfm?partnumber=PH2 | thorlabs | PH2
 |  | H45 - 45° Mirror Mount for Ø1" Optics | 1 | 33.75 | https://www.thorlabs.com/thorproduct.cfm?partnumber=H45 | thorlabs | H45
 |  | PF10-03-P01 - Ø1" Protected Silver Mirror | 1 | 52.02 | https://www.thorlabs.com/thorproduct.cfm?partnumber=PF10-03-P01 | thorlabs | PF10-03-P01
 | > | TR2 - Ø1/2" Optical Post, SS, 8-32 Setscrew, 1/4"-20 Tap, L = 2" | 1 | 5.19 | https://www.thorlabs.com/thorproduct.cfm?partnumber=TR2 | thorlabs | TR2 |  |  |  | reflectance >97.5% for 450 nm - 2 µm (-P01)
 | first upper mirror< | XT66C4 - Clamping Platform for 66 mm Rails, 1/4" Counterbored Slot, 40 mm Long | 1 | 28.56 | https://www.thorlabs.com/thorproduct.cfm?partnumber=XT66C4 | thorlabs | XT66C4
 |  | PH1 - Ø1/2" Post Holder, Spring-Loaded Hex-Locking Thumbscrew, L = 1" | 1 | 7.03 | https://www.thorlabs.com/thorproduct.cfm?partnumber=PH1 | thorlabs | PH1
 |  | TR1 - Ø1/2" Optical Post, SS, 8-32 Setscrew, 1/4"-20 Tap, L = 1" | 1 | 4.74 | https://www.thorlabs.com/thorproduct.cfm?partnumber=TR1 | thorlabs | TR1
 |  | MA45-2 - 45° Mounting Adapter, Compatible with KM100 and KM200, 8-32 and 1/4"-20 Taps | 1 | 21.52 | https://www.thorlabs.com/thorproduct.cfm?partnumber=MA45-2 | thorlabs | MA45-2
 |  | KM100 - Kinematic Mirror Mount for Ø1" Optics | 1 | 38.70 | https://www.thorlabs.com/thorproduct.cfm?partnumber=KM100=ad-image-0 | thorlabs | KM100
 | > | PF10-03-P01 - Ø1" Protected Silver Mirror | 1 | 52.02 | https://www.thorlabs.com/thorproduct.cfm?partnumber=PF10-03-P01 | thorlabs | PF10-03-P01
 | 2nd upper mirror< | XT66C4 - Clamping Platform for 66 mm Rails, 1/4" Counterbored Slot, 40 mm Long | 1 | 28.56 | https://www.thorlabs.com/thorproduct.cfm?partnumber=XT66C4 | thorlabs | XT66C4 |  |  |  | reflectance >97.5% for 450 nm - 2 µm (-P01)
 |  | PH1 - Ø1/2" Post Holder, Spring-Loaded Hex-Locking Thumbscrew, L = 1" | 1 | 7.03 | https://www.thorlabs.com/thorproduct.cfm?partnumber=PH1 | thorlabs | PH1
 |  | TR2 - Ø1/2" Optical Post, SS, 8-32 Setscrew, 1/4"-20 Tap, L = 2" | 1 | 5.19 | https://www.thorlabs.com/thorproduct.cfm?partnumber=TR2 | thorlabs | TR2
 |  | KM100 - Kinematic Mirror Mount for Ø1" Optics | 1 | 38.70 | https://www.thorlabs.com/thorproduct.cfm?partnumber=KM100=ad-image-0 | thorlabs | KM100
 | > | PF10-03-P01 - Ø1" Protected Silver Mirror | 1 | 52.02 | https://www.thorlabs.com/thorproduct.cfm?partnumber=PF10-03-P01 | thorlabs | PF10-03-P01
 | >

Sheet: scanner
cat1 | cat0 | assembly | Part name | Qty | Price ea, $ | url | vendor | catalog # | pic | lead time, weeks | extra info | cond | Notes
Liquid lens setups <
 |  | Liquid lens with electronics, v1< |  |  | 720.00
 |  |  | Optotune Electrically Focus-Tunable Lens EL-10-30-TC, NIR Coated | 1 | 440.00 | https://www.optotune.com/products/focus-tunable-lenses | optotune | EL-10-30-TC |  |  |  |  | Bought in Edmund Optics -- not available any more
 |  | > | Optotune Electrical Lens Driver (=88-940) | 1 | 280.00 |  | optotune
 |  | Liquid lens with electronics, v2 < |  |  | 930.00
 |  |  | EL-10-30-CI-NIR-LD-MV | 1 | 540.00 | https://www.edmundoptics.com/p/-15-to-35-diopters-nir-optotune-industrial-focus-tunable-lens/32184/ | edmundoptics | 89-747
 |  |  | Optotune Industrial Electrical Lens Driver | 1 | 280.00 | https://www.edmundoptics.com/p/optotune-industrial-electrical-lens-driver/31422/ | edmundoptics | 88-940
 |  | > | 6-way Male/Female Hirose Cable, 3m Length | 1 | 110.00 | https://www.edmundoptics.com/p/6-way-malefemale-hirose-cable-3m-length/3163/ | edmundoptics | 33-468
 | single ETL, stand-alone mounted on the collimated laser path <
 |  |  | Liquid lens with electronics, v1< | 1 | 720.00 |  |  |  | 0
 |  | ETL mount, stand-alone, v1 < |  |  | 100.24
 |  |  | VC1 - Small V-Clamp with PM3 Clamping Arm, 0.75" Long | 1 | 40.55 | https://www.thorlabs.com/thorproduct.cfm?partnumber=VC1 | thorlabs | VC1 |  |  |  |  | Comes with PM4 arm, which isn't large enough for the liquid lens and has to be replaced with the PM4 arm
 |  |  | PM4 - Large Adjustable Clamping Arm, 6-32 Threaded Post | 1 | 22.95 | https://www.thorlabs.com/thorproduct.cfm?partnumber=PM4 | thorlabs | PM4
 |  |  | TR1 - Ø1/2" Optical Post, SS, 8-32 Setscrew, 1/4"-20 Tap, L = 1" | 1 | 4.74 | https://www.thorlabs.com/thorproduct.cfm?partnumber=TR1 | thorlabs | TR1
 |  |  | RA180 - Right-Angle End Clamp for Ø1/2" Posts, 1/4"-20 Stud and 3/16" Hex | 2 | 10.81 | https://www.thorlabs.com/thorproduct.cfm?partnumber=RA180 | thorlabs | RA180
 | > | > | TR2 - Ø1/2" Optical Post, SS, 8-32 Setscrew, 1/4"-20 Tap, L = 2" | 2 | 5.19 | https://www.thorlabs.com/thorproduct.cfm?partnumber=TR2 | thorlabs | TR2
 | Conjugated ETL z-scanner 1 <
 |  | Conjugated ETL z-scanner optical components 1 < |  |  | 1879.26
 |  |  | KCB1C+UM10-AG - right angle, rod bores, 30mm cage, ultrafast mirror < | 1 | 252.26 |  |  |  | KCB1C+UM10-AG - right angle_rod bores_30mm cage_ultrafast mirror.png
 |  |  | SPT1 - Coarse ±1 mm XY Slip Plate Positioner, 30 mm Cage Compatible | 3 | 66.55 | https://www.thorlabs.com/thorproduct.cfm?partnumber=SPT1 | thorlabs | SPT1 | SPT1.jpg
 |  |  | SM1A16 - Adapter with External SM1 Threads and Internal SM30 Threads | 2 | 21.93 | https://www.thorlabs.com/thorproduct.cfm?partnumber#SM1A16 | thorlabs | SM1A16 | 0 | 0 | 0
 |  |  | SM30L10 - SM30 Lens Tube, 1" Thread Depth, One Retaining Ring Included | 2 | 30.09 | https://www.thorlabs.com/thorproduct.cfm?partnumber=SM30L10 | thorlabs | SM30L10 | 0 | 0 | 0
 |  |  | AC300-080-B - f=80.0 mm, Ø30.0 mm Achromatic Doublet, ARC: 650-1050 nm | 4 | 93.33 | https://www.thorlabs.com/thorproduct.cfm?partnumber=AC300-080-B | thorlabs | AC300-080-B | 0 | 0 | 0
 |  |  | SM1A39 - Adapter with External C-Mount Threads and External SM1 Threads | 1 | 19.99 | https://www.thorlabs.com/thorproduct.cfm?partnumber=SM1A39 | thorlabs | SM1A39 | 0 | 0 | 0
 |  | > | Liquid lens with electronics, v2 < | 1 | 930.00 |  |  |  | 0
 |  | connecting rods < |  |  | 109.45
 |  |  | ER1.5 - Cage Assembly Rod, 1.5" Long, Ø6 mm | 3 | 5.85 | https://www.thorlabs.com/thorproduct.cfm?partnumber=ER1.5 | thorlabs | ER1.5 | ER1.5.jpg | 0 | 0
 |  |  | ER6 - Cage Assembly Rod, 6" Long, Ø6 mm | 3 | 8.65 | https://www.thorlabs.com/thorproduct.cfm?partnumber=ER6 | thorlabs | ER6 | ER6.jpg | 0 | 0
 |  |  | ER1 - Cage Assembly Rod, 1" Long, Ø6 mm | 3 | 5.05 | https://www.thorlabs.com/thorproduct.cfm?partnumber=ER1 | thorlabs | ER1 | ER1.jpg | 0 | 0
 |  | > | ER10 - Cage Assembly Rod, 10" Long, Ø6 mm | 4 | 12.70 | https://www.thorlabs.com/thorproduct.cfm?partnumber=ER10 | thorlabs | ER10 | ER10.jpg | 0 | 0
 |  | mounting -1 < |  |  | 247.78
 |  |  | LCP01 - 60 mm Cage Plate, SM2 Threads, 0.5" Thick, 8-32 Tap (Two SM2RR Retaining Rings Included) | 1 | 38.76 | https://www.thorlabs.com/thorproduct.cfm?partnumber=LCP01 | thorlabs | LCP01 | 0 | 0 | 0
 |  |  | LCP02 - 30 mm to 60 mm Cage Plate Adapter, 8-32 Tap | 1 | 39.78 | https://www.thorlabs.com/thorproduct.cfm?partnumber=LCP02 | thorlabs | LCP02 | 0 | 0 | 0
 |  |  | LCP01B - 60 mm Cage Mounting Bracket | 1 | 30.35 | https://www.thorlabs.com/thorproduct.cfm?partnumber#LCP01B | thorlabs | LCP01B | 0 | 0 | 0
 |  |  | LCP09 - 60 mm Cage Plate with Ø2.2" (Ø56.0 mm) Double Bore for SM2 Lens Tube Mounting | 1 | 45.72 | https://www.thorlabs.com/thorproduct.cfm?partnumber=LCP09 | thorlabs | LCP09 | 0 | 0 | 0
 |  |  | 3" post assembly with short base < | 3 | 18.89 | 0.00 | 0.00 | 0.00 | 0.00 | 0 | 0.00
 |  | > | 4" post assembly, pedestal mounted < | 1 | 36.50 |  |  |  | 0
 |  | ETL mounted z-scanner 1 < |  |  | 2236.49
 |  |  | Conjugated ETL z-scanner optical components 1 < | 1 | 1879.26
 |  |  | connecting rods < | 1 | 109.45
> |  | > | mounting -1 < | 1 | 247.78
Galvo-mirror scanners <
 |  | 45 degree, 30 mm caged mirror < |  |  | 252.16
 |  |  | CP360R - Pivoting, Quick-Release, Ø1" Optic Mount for 30 mm Cage System | 1 | 95.63 | https://www.thorlabs.com/thorproduct.cfm?partnumber=CP360R | thorlabs | CP360R
 |  |  | PF10-03-P01 - Ø1" Protected Silver Mirror | 1 | 52.02 | https://www.thorlabs.com/thorproduct.cfm?partnumber=PF10-03-P01 | thorlabs | PF10-03-P01
 |  |  | ER90B - Fixed 90° Bracket, Ø6 mm Bore and 4-40 Taps | 2 | 14.28 | https://www.thorlabs.com/thorproduct.cfm?partnumber=ER90B | thorlabs | ER90B
 |  |  | ER2 - Cage Assembly Rod, 2" Long, Ø6 mm | 2 | 6.10 | https://www.thorlabs.com/thorproduct.cfm?partnumber=ER2 | thorlabs | ER2
 |  | > | C6W - 30 mm Cage Cube, Ø6 mm Through Holes | 1 | 63.75 | https://www.thorlabs.com/thorproduct.cfm?partnumber=C6W | thorlabs | C6W
 |  | 45 degree, 30 mm caged mirror with extra mount points < |  |  | 368.14
 |  |  | 45 degree, 30 mm caged mirror < | 1 | 252.16
 |  |  | ER90B - Fixed 90° Bracket, Ø6 mm Bore and 4-40 Taps | 6 | 14.28 | https://www.thorlabs.com/thorproduct.cfm?partnumber=ER90B | thorlabs | ER90B
 |  |  | ER1 - Cage Assembly Rod, 1" Long, Ø6 mm | 2 | 5.05 | https://www.thorlabs.com/thorproduct.cfm?partnumber=ER1 | thorlabs | ER1
 |  | > | ER05 - Cage Assembly Rod, 1/2" Long, Ø6 mm | 4 | 5.05 | https://www.thorlabs.com/thorproduct.cfm?partnumber=ER05 | thorlabs | ER05
 |  | galvo-parbolic-conjugate-system, unmounted < |  |  | 5582.69
 |  |  | Cambridge Tech 6210H with 3mm (6x5mm) 6110 mirror and cables | 2 | 2408.00 |  | Cambridge Tech | 6SD12047 |  | 12-16 |  |  | SYS 1X, 3MM S1, 6210H, 671-1, 40 DEG OPT, +/-28V PS, +/-10V, CMD, 203CM CABLE, NOMNT (X)
 |  |  | MPD229-M01 - Ø2" 90° Off-Axis Parabolic Mirror, Prot. Gold, RFL = 2" | 2 | 333.54 | https://www.thorlabs.com/thorproduct.cfm?partnumber=MPD229-M01 | thorlabs | MPD229-M01 | 0 | 0 | 0
 |  |  | FMP2 - Fixed Ø2" Mirror Mount, 8-32 Tap | 2 | 21.11 | https://www.thorlabs.com/thorproduct.cfm?partnumber=FMP2 | thorlabs | FMP2
 |  |  | LCP02 - 30 mm to 60 mm Cage Plate Adapter, 8-32 Tap | 1 | 39.78 | https://www.thorlabs.com/thorproduct.cfm?partnumber=LCP02 | thorlabs | LCP02
 |  |  | CP06 - 30 mm Cage Plate with Ø1" Double Bore, 8-32 Tap | 1 | 17.61 | https://www.thorlabs.com/thorproduct.cfm?partnumber=CP06 | thorlabs | CP06
 |  |  | metal for DIY galvo mounts | 1
 |  |  | Oversized 6061 Aluminum Sheet, 3/4" Thick, 6" x 6" | 1 | 37.81 | https://www.mcmaster.com/89155K153 | mcmaster | 89155K153 |  |  |  |  | thermal conductivity: 116 Btu/hr/ft/F @75F
 |  | > | Multipurpose 110 Copper Sheet, 1/8 to 1/4 Hard Temper, 6" x 6", 3/4" Thick | 1 | 133.44 | https://www.mcmaster.com/8995K56 | mcmaster | 8995K56 |  |  |  |  | thermal conductivity: 226 Btu/hr/ft/F @68F
 |  | galvo-parbolic-conjugate-system connecting rods < |  |  | 69.60
 |  |  | ER10 - Cage Assembly Rod, 10" Long, Ø6 mm | 5 | 12.70 | https://www.thorlabs.com/thorproduct.cfm?partnumber=ER10 | thorlabs | ER10
 |  | > | ER2 - Cage Assembly Rod, 2" Long, Ø6 mm | 1 | 6.10 | https://www.thorlabs.com/thorproduct.cfm?partnumber=ER2 | thorlabs | ER6
 |  | galvo-parbolic-conjugate-system mount < |  |  | 591.55
 |  |  | 1.5" post assembly < | 2 | 12.19
 |  |  | 2" post assembly < | 3 | 12.89
 |  |  | RC1 - Dovetail Rail Carrier, 1.00" x 1.00" (25.4 mm x 25.4 mm), 1/4" (M6) Counterbore | 9 | 25.40 | https://www.thorlabs.com/thorproduct.cfm?partnumber=RC1 | thorlabs | RC1
 |  |  | RC3 - Rail Carrier, Perpendicular Dovetail | 2 | 30.60 | https://www.thorlabs.com/thorproduct.cfm?partnumber=RC3 | thorlabs | RC3
 |  |  | RLA1200 - Dovetail Optical Rail, 12", Imperial | 2 | 76.25 | https://www.thorlabs.com/thorproduct.cfm?partnumber=RLA1200 | thorlabs | RLA1200
 |  | > | RLA0600 - Dovetail Optical Rail, 6", Imperial | 2 | 43.10 | https://www.thorlabs.com/thorproduct.cfm?partnumber=RLA0600 | thorlabs | RLA0600
 |  | 2D angle adjustment for the parabolic mirrors -1 < |  |  | 153.75
 |  |  | LCP01 - 60 mm Cage Plate, SM2 Threads, 0.5" Thick, 8-32 Tap (Two SM2RR Retaining Rings Included) | 1 | 38.76 | https://www.thorlabs.com/thorproduct.cfm?partnumber=LCP01 | thorlabs | LCP01 | 0 | 0 | 0 | orig
 |  |  | SM2A30 - Adapter with External SM2 Threads and Internal M43 x 0.5 Threads | 1 | 16.56 | https://www.thorlabs.com/thorproduct.cfm?partnumber#SM2A30 | thorlabs | SM2A30 | 0 | 0 | 0 | mod
 |  |  | B4C - Kinematic Cage Cube Platform for C4W/C6W | 1 | 98.43 | https://www.thorlabs.com/thorproduct.cfm?partnumber=B4C | thorlabs | B4C | B4C.jpg | 0 | 0 | orig
 |  | > | 2D angle adjustment for the parabolic mirrors 1, DIY parts |  |  |  |  | DIY |  |  |  | diy
 |  | 2D angle adjustment for the parabolic mirrors -2 < |  |  | 98.43
 |  |  | B4C - Kinematic Cage Cube Platform for C4W/C6W | 1 | 98.43 | https://www.thorlabs.com/thorproduct.cfm?partnumber=B4C | thorlabs | B4C | B4C.jpg | 0 | 0
 |  | > | 2D angle adjustment for the parabolic mirrors 2, DIY parts | 1
 |  | 2 3mm telecentric galvos, 2"EFL 2" parabolic mirror scanner 1 < |  |  | 6611.98
 |  |  | galvo-parbolic-conjugate-system, unmounted < | 1 | 5582.69
 |  |  | galvo-parbolic-conjugate-system connecting rods < | 1 | 69.60
 |  |  | galvo-parbolic-conjugate-system mount < | 1 | 591.55
> |  | > | 45 degree, 30 mm caged mirror with extra mount points < | 1 | 368.14
 |  | galvo-parbolic-conjugate-system, unmounted < |  |  | 5922.27
 |  |  | 2D angle adjustment for the parabolic mirrors -2 < | 2 | 98.43 |  |  |  | galvo-parabolic-conjugate-asmbly2.png
 |  |  | MPD229-M01 - Ø2" 90° Off-Axis Parabolic Mirror, Prot. Gold, RFL = 2" | 2 | 333.54 | https://www.thorlabs.com/thorproduct.cfm?partnumber=MPD229-M01 | thorlabs | MPD229-M01 | 0 | 0 | 0
 |  |  | Cambridge Tech 6210H mounted in C6W < | 2 | 2471.75 |  |  |  | 0
 |  |  | CP08 - SM1-Threaded 30 mm Cage Plate with Flexure Clamping, 1 Retaining Ring, 8-32 Tap | 2 | 19.79 | https://www.thorlabs.com/thorproduct.cfm?partnumber=CP08 | thorlabs | CP08 | CP08.jpg | 0 | 0
 |  |  | ER10 - Cage Assembly Rod, 10" Long, Ø6 mm | 2 | 12.70 | https://www.thorlabs.com/thorproduct.cfm?partnumber=ER10 | thorlabs | ER10 | ER10.jpg | 0 | 0
 |  |  | ER8 - Cage Assembly Rod, 8" Long, Ø6 mm | 3 | 12.05 | https://www.thorlabs.com/thorproduct.cfm?partnumber=ER8 | thorlabs | ER8 | ER8.jpg | 0 | 0
 |  |  | ER6 - Cage Assembly Rod, 6" Long, Ø6 mm | 1 | 8.65 | https://www.thorlabs.com/thorproduct.cfm?partnumber=ER6 | thorlabs | ER6 | ER6.jpg | 0 | 0
 |  | > | ER05 - Cage Assembly Rod, 1/2" Long, Ø6 mm | 1 | 5.05 | https://www.thorlabs.com/thorproduct.cfm?partnumber=ER05 | thorlabs | ER05 | ER05.jpg | 0 | 0
 |  | galvo-parbolic-conjugate-system mount < |  |  | 315.86
 |  |  | MB8 - Aluminum Breadboard 8" x 8" x 1/2", 1/4"-20 Taps | 1 | 77.22 | https://www.thorlabs.com/thorproduct.cfm?partnumber#MB8 | thorlabs | MB8 | 0 | 0 | 0
 |  |  | 3" post assembly < | 1 | 13.69 |  |  |  | 0
 |  |  | 3" post assembly with short base < | 3 | 18.89 |  |  |  | 0
 |  | > | DT12 - 1/2" Dovetail Translation Stage, 8-32 Taps | 2 | 84.14 | https://www.thorlabs.com/thorproduct.cfm?partnumber=DT12 | thorlabs | DT12 | 0 | 0 | 0
scan-tube lens assembly <
 | Scan lenses <
 |  | Single Ø30 Achromat Doublet, 30mm cage system mount < |  |  | 46.82
 |  |  | CP03 - Ø35 mm Aperture, 30 mm Cage Plate, 0.35" Thick, 8-32 Tap | 1 | 18.77 | https://www.thorlabs.com/thorproduct.cfm?partnumber=CP03 | thorlabs | CP03
 |  | > | SM30L05 - SM30 Lens Tube, 1/2" Thread Depth, One Retaining Ring Included | 1 | 28.05 | https://www.thorlabs.com/thorproduct.cfm?partnumber=SM30L05 | thorlabs | SM30L05
 |  | 50mm FL, Ø30 Achromat Doublet, w/o XY adjustment < |  |  | 140.15
 |  |  | AC300-050-B - f=50.0 mm, Ø30.0 mm Achromatic Doublet, ARC: 650-1050 nm | 1 | 93.33 | https://www.thorlabs.com/thorproduct.cfm?partnumber=AC300-050-B | thorlabs | AC300-050-B
 |  | > | Single Ø30 Achromat Doublet, 30mm cage system mount < | 1 | 46.82 |  |  | AC300-050-B
 |  | 50mm FL, Ø30 Achromat Doublet, with XY adjustment < |  |  | 321.39
 |  |  | AC300-050-B - f=50.0 mm, Ø30.0 mm Achromatic Doublet, ARC: 650-1050 nm | 1 | 93.33 | https://www.thorlabs.com/thorproduct.cfm?partnumber=AC300-050-B | thorlabs | AC300-050-B
 |  |  | CXY2 - 60 mm Cage System Translating Lens Mount for Ø2" Optics | 1 | 198.45 | https://www.thorlabs.com/thorproduct.cfm?partnumber=CXY2 | thorlabs | CXY2
 |  | > | SM2AD30 - SM2-Threaded Mounting Adapter for Ø30 mm Optics | 1 | 29.61 | https://www.thorlabs.com/thorproduct.cfm?partnumber=SM2AD30 | thorlabs | SM2AD30 |  |  |  |  | adapter to insert AC300-050-B into 2" mounts
 |  | Plössl-type scan lens, 30mm cage system mount 1 < |  |  | 48.86
 |  |  | CP03 - Ø35 mm Aperture, 30 mm Cage Plate, 0.35" Thick, 8-32 Tap | 1 | 18.77 | https://www.thorlabs.com/thorproduct.cfm?partnumber=CP03 | thorlabs | CP03
 |  |  | ? 8-32 x 3/8 set screw |  |  |  |  |  |  |  |  |  | To attach the mount to the rod. The 8-32 set screw coming with the rod is too long
 |  |  | SM30L10 - SM30 Lens Tube, 1" Thread Depth, One Retaining Ring Included | 1 | 30.09 | https://www.thorlabs.com/thorproduct.cfm?partnumber=SM30L10 | thorlabs | SM30L10
 |  | > | SM30RR - SM30 Retaining Ring for Ø30 mm Lens Mounts | 1 | 11.07 | https://www.thorlabs.com/thorproduct.cfm?partnumber=SM30RR | thorlabs | SM30RR
 |  | Plössl-type scan lens, 30mm cage system mount -2 < |  |  | 96.64
 |  |  | SPT1 - Coarse ±1 mm XY Slip Plate Positioner, 30 mm Cage Compatible | 1 | 66.55 | https://www.thorlabs.com/thorproduct.cfm?partnumber=SPT1 | thorlabs | SPT1 | SPT1.jpg | 0 | 0
 |  |  | SM30L10 - SM30 Lens Tube, 1" Thread Depth, One Retaining Ring Included | 1 | 30.09 | https://www.thorlabs.com/thorproduct.cfm?partnumber=SM30L10 | thorlabs | SM30L10
 |  | > | SM30RR - SM30 Retaining Ring for Ø30 mm Lens Mounts | 1 | 11.07 | https://www.thorlabs.com/thorproduct.cfm?partnumber=SM30RR | thorlabs | SM30RR
 |  | Plössl-type 40mm scan lens < |  |  | 283.30
 |  |  | AC300-080-B - f=80.0 mm, Ø30.0 mm Achromatic Doublet, ARC: 650-1050 nm | 2 | 93.33 | https://www.thorlabs.com/thorproduct.cfm?partnumber=AC300-080-B | thorlabs | AC300-080-B
 |  | > | Plössl-type scan lens, 30mm cage system mount -2 < | 1 | 96.64 |  |  |  | 0
 |  | Plössl-type 50mm scan lens < |  |  | 235.52
 |  |  | AC300-100-B - f=100.0 mm, Ø30.0 mm Achromatic Doublet, ARC: 650-1050 nm | 2 | 93.33 | https://www.thorlabs.com/thorproduct.cfm?partnumber=AC300-100-B | thorlabs | AC300-100-B
 |  | > | Plössl-type scan lens, 30mm cage system mount 1 < | 1 | 48.86
 | Commercial telecentric lenses <
 |  | Thorlabs SL50-CLS2 with 30mm cage system mount <
 |  |  | SL50-CLS2 - Scan Lens, 450 to 1100 nm, EFL=50 mm | 1 | 3070.20 | https://www.thorlabs.com/thorproduct.cfm?partnumber=SL50-CLS2 | thorlabs | SL50-CLS2
 |  |  | SM1A16 |  |  |  |  | SM1A16
 |  | > | CP4S |  |  |  |  | CP4S
 |  | LSM54-1050 with 30mm cage system mount <
 |  |  | LSM54-1050 - Scan Lens, 950 to 1150 nm, EFL=54 mm | 1 | 1564.68 | https://www.thorlabs.com/newgrouppage9.cfm?objectgroup_id=2910&pn=LSM54-1050 | thorlabs | LSM54-1050 |  |  |  |  | Might not be suitable for the high-energy, high-rep rate fs lasers due to the cement, not tested in such conditions (different from many other cemented pieces at Thorlabs, made by a suppliers in Sweden). See correspondence.
 |  |  | SM1A12 - Adapter with External SM1 Threads and Internal M25 x 0.75 Threads | 1 | 21.86 | https://www.thorlabs.com/thorproduct.cfm?partnumber=SM1A12 | thorlabs | SM1A12
 | >> | > | CP4S |  |  |  |  | CP4S
Tube lenses <
 | Single Achromat doublets < |  |  |  |  |  |  |  |  |  |  |  | Good for use with Olympus objectives, which contain all the necessary distortion corrections inside. For Zeiss need to compensate for axial shift ?+smth else?
 |  |  | AC508-200-B - f=200.0 mm, Ø2" Achromatic Doublet, ARC: 650-1050 nm | 1 | 134.64 | https://www.thorlabs.com/thorproduct.cfm?partnumber=AC508-200-B | thorlabs | AC508-200-B
 |  |  | AC508-300-B - f=300.0 mm, Ø2" Achromatic Doublet, ARC: 650-1050 nm | 1 | 134.64 | https://www.thorlabs.com/thorproduct.cfm?partnumber=AC508-300-B | thorlabs | AC508-300-B
 | > |  | AC508-250-B - f=250.0 mm, Ø2" Achromatic Doublet, ARC: 650-1050 nm | 1 | 134.64 | https://www.thorlabs.com/thorproduct.cfm?partnumber=AC508-250-B | thorlabs | AC508-250-B
 |  | Mounted 250mm tube lens, AC508-250-B + CXY2 < |  |  | 333.09
 |  |  | AC508-250-B - f=250.0 mm, Ø2" Achromatic Doublet, ARC: 650-1050 nm | 1 | 134.64 | https://www.thorlabs.com/thorproduct.cfm?partnumber=AC508-250-B | thorlabs | AC508-250-B | 0.00
> |  | > | CXY2 - 60 mm Cage System Translating Lens Mount for Ø2" Optics | 1 | 198.45 | https://www.thorlabs.com/thorproduct.cfm?partnumber=CXY2 | thorlabs | CXY2 | 0 | 0 | 0
 | Scanner telescope < |  |  |  |  |  |  |  |  |  |  |  | Scan lens + Tube lens + steering mirrors + mounting
 |  | Scanner telescope mech: 60/30mm cage system, 180deg mirrors < |  |  | 914.21
 |  |  | KCB2C - Right-Angle Kinematic Mirror Mount with Smooth Cage Rod Bores, 60 mm Cage System and SM2 Compatible, 8-32 and 1/4"-20 Mounting Holes | 2 | 168.92 | https://www.thorlabs.com/thorproduct.cfm?partnumber=KCB2C | thorlabs | KCB2C |  |  |  |  | A more flexible choice than KCB2, as it allows connecting the cubes directly, without LCP01
 |  |  | PF20-03-P01 - Ø2" Protected Silver Mirror | 2 | 106.08 | https://www.thorlabs.com/thorproduct.cfm?partnumber=PF20-03-P01 | thorlabs | PF20-03-P01
 |  |  | CXY2 - 60 mm Cage System Translating Lens Mount for Ø2" Optics | 1 | 198.45 | https://www.thorlabs.com/thorproduct.cfm?partnumber=CXY2 | thorlabs | CXY2 | 0 | 0 | 0
 |  |  | LCP02 - 30 mm to 60 mm Cage Plate Adapter, 8-32 Tap | 1 | 39.78 | https://www.thorlabs.com/thorproduct.cfm?partnumber=LCP02 | thorlabs | LCP02
 |  |  | LCP08 - 60 mm Cage Plate, SM2 Threads, Enhanced Clamping, 0.5" Thick, 8-32 Tap (One SM2RR Retaining Ring Included) | 1 | 49.98 | https://www.thorlabs.com/thorproduct.cfm?partnumber#LCP08 | thorlabs | LCP08
 |  |  | ER4 - Cage Assembly Rod, 4" Long, Ø6 mm | 6 | 7.10 | https://www.thorlabs.com/thorproduct.cfm?partnumber=ER4 | thorlabs | ER4
 |  |  | ER3 - Cage Assembly Rod, 3" Long, Ø6 mm | 2 | 6.60 | https://www.thorlabs.com/thorproduct.cfm?partnumber=ER3 | thorlabs | ER3
 |  | > | ER05 - Cage Assembly Rod, 1/2" Long, Ø6 mm | 4 | 5.05 | https://www.thorlabs.com/thorproduct.cfm?partnumber=ER05 | thorlabs | ER05
 |  | Scanner telescope 2" 180degree steering and suport -2 |  |  | 706.23 |  |  |  |  |  |  |  | Assuming that the supporting rods for the first 2" steering mirror are included with another assembly (e.g., the parabolic mirror, or the ETL assembly)
 |  |  | 2" mounted mirror: KCB2C + PF20-03-01 < | 2 | 275.00
 |  |  | LCP01 - 60 mm Cage Plate, SM2 Threads, 0.5" Thick, 8-32 Tap (Two SM2RR Retaining Rings Included) | 1 | 38.76 | https://www.thorlabs.com/thorproduct.cfm?partnumber=LCP01 | thorlabs | LCP01 | 0 | 0 | 0
 |  |  | LCP08 - 60 mm Cage Plate, SM2 Threads, Enhanced Clamping, 0.5" Thick, 8-32 Tap (One SM2RR Retaining Ring Included) | 1 | 49.98 | https://www.thorlabs.com/thorproduct.cfm?partnumber#LCP08 | thorlabs | LCP08 | 0 | 0 | 0
 |  |  | ER4 - Cage Assembly Rod, 4" Long, Ø6 mm | 4 | 7.10 | https://www.thorlabs.com/thorproduct.cfm?partnumber=ER4 | thorlabs | ER4 | ER4.jpg | 0 | 0
 |  |  | ER1 - Cage Assembly Rod, 1" Long, Ø6 mm | 4 | 5.05 | https://www.thorlabs.com/thorproduct.cfm?partnumber=ER1 | thorlabs | ER1 | ER1.jpg | 0 | 0
 |  | > | 3" post assembly with short base < | 1 | 18.89
 |  | Scanner telescope: 200mm tube/40mm scan lens, 60/30mm cage system, 180deg mirrors < |  |  | 1332.15
 |  |  | 2" mounted mirror: KCB2C + PF20-03-01 < | 2 | 275.00
 |  |  | Plössl-type 40mm scan lens < | 1 | 283.30
 |  |  | AC508-200-B - f=200.0 mm, Ø2" Achromatic Doublet, ARC: 650-1050 nm | 1 | 134.64 | https://www.thorlabs.com/thorproduct.cfm?partnumber=AC508-200-B | thorlabs | AC508-200-B
 | > | > | Scanner telescope mech: 60/30mm cage system, 180deg mirrors < | 1 | 914.21
>
 | Full scanner Assemblies <
 |  | scanner 1 < |  |  | 8664.13
 |  |  | 2 3mm telecentric galvos, 2"EFL 2" parabolic mirror scanner 1 < | 1 | 6611.98
 |  |  | Scanner telescope: 200mm tube/40mm scan lens, 60/30mm cage system, 180deg mirrors < | 1 | 1332.15
 |  | > | Liquid lens with electronics, v1< | 1 | 720.00
 | Misc <
 |  |  | UPH1 - Ø1/2" Universal Post Holder, Spring-Loaded Locking Thumbscrew, L = 1" | 2 | 30.35 | https://www.thorlabs.com/thorproduct.cfm?partnumber=UPH1 | thorlabs | UPH1
 |  |  | KL03 - Spring-Loaded Plunger, 0.85" (21.6 mm) Long Slot | 2 | 29.61 | https://www.thorlabs.com/thorproduct.cfm?partnumber=KL03 | thorlabs | KL03
 |  |  | KL02 - Adjustable Kinematic Positioner, 0.85" (21.6 mm) Long Slot | 4 | 23.66 | https://www.thorlabs.com/thorproduct.cfm?partnumber=KL02 | thorlabs | KL02
 |  |  | CL2 - Heavy-Duty Variable Height Clamp, 1/4"-20 Tapped | 2 | 6.99 | https://www.thorlabs.com/thorproduct.cfm?partnumber=CL2 | thorlabs | CL2
 |  |  | BA1L - Mounting Base, 1" x 4.5" x 3/8" | 2 | 12.55 | https://www.thorlabs.com/thorproduct.cfm?partnumber=BA1L=ad-image-0 | thorlabs | BA1L
 |  | Thorlabs 2in, 2in EFL smaller alternative <
 |  |  | Off-Axis Replicated Parabolic Mirror, 1.5 in., 2.0 in. EFL, Bare Gold | 2 | 322.00 | https://www.newport.com/p/50329AU | newport | 50329AU
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
