nikitchm/naumannlab_2p1/projects/common parts & manuals/electronics/Uctronics-power-source_mount/v2.1/laser_module_power_control_mount_v2.1.stl

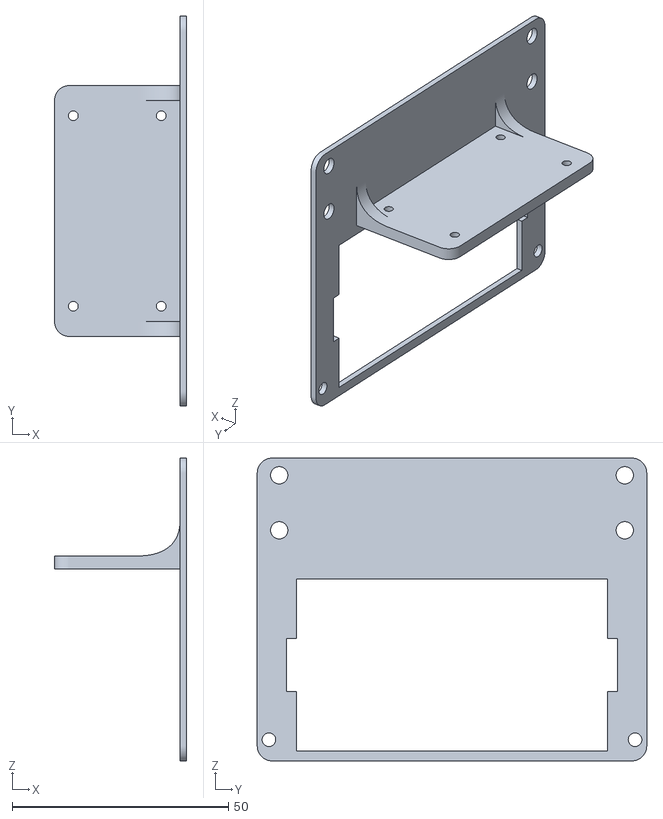
[picture p1: CAD file, 2024-08-05]
projects/common parts & manuals/electronics/Uctronics-power-source_mount/v2.1/laser_module_power_control_mount_v2.1.stl
30.5 x 90.0 x 70.0
