nikitchm/naumannlab_2p1/projects/common parts & manuals/Olympus objective/files/N20X-PFH-Objective.step

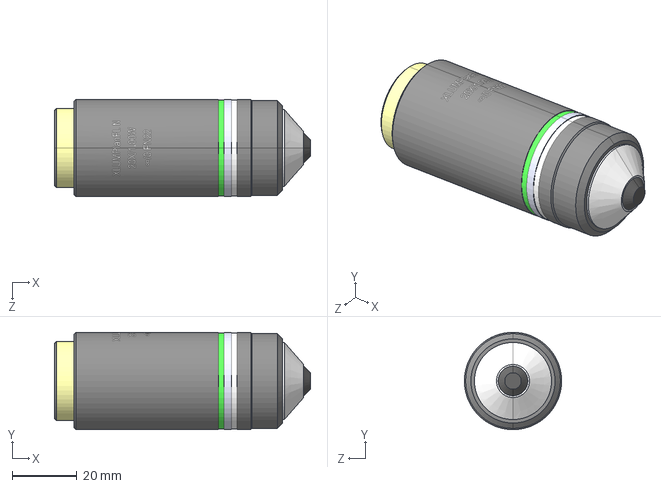
[picture p2: CAD file, 2024-08-05]
projects/common parts & manuals/Olympus objective/files/N20X-PFH-Objective.step
78.9 x 30.0 x 30.0 mm
