nikitchm/naumannlab_2p1/(list of files, cad)

Other CAD files:
projects/common parts & manuals/electronics/Uctronics-power-source_mount/v2.1/laser_module_power_control_mount_v2.1_UMS3.3mf
projects/common parts & manuals/electronics/Uctronics-power-source_mount/v1/laser_module_power_control_mount.stl
projects/common parts & manuals/electronics/Uctronics-power-source_mount/v2/UMS3_laser_module_power_control_mount_v2.3mf
projects/common parts & manuals/electronics/Uctronics-power-source_mount/v1/UMS3_laser_module_power_control_mount.3mf
projects/common parts & manuals/electronics/Uctronics-power-source_mount/v2/laser_module_power_control_mount_v2.stl
projects/common parts & manuals/electronics/Uctronics-power-source_mount/v1/laser_module_power_control_mount v2.f3d
projects/common parts & manuals/electronics/Uctronics-power-source_mount/v2.1/laser_module_power_control_mount v7.f3d
projects/common parts & manuals/electronics/Uctronics-power-source_mount/v2/laser_module_power_control_mount v6.f3d
