nikitchm/naumannlab_2p1/(commit log)

2024-08-02 added NL-2p1_html folders
    [2p-scanning.xlsx]
2024-08-05 Added 'common parts & manuals' folder. Modified NL_2p1\files\NL-2p1_asmbly.xlsx.md -> html to temporarily directly refer to the .xlsx file on github
    [N20X-PFH-Objective.step, UMS3_laser_module_power_control_mount.3mf, UMS3_laser_module_power_control_mount_v2.3mf, laser_module_power_control_mount v2.f3d, laser_module_power_control_mount v6.f3d, laser_module_power_control_mount v7.f3d, laser_module_power_control_mount.stl, laser_module_power_control_mount_v2.1.stl]
